netbomo/datalogger-project/Firmware/readme.md

# FIRMWARE [Development branch!]
Here are firmware's files for the windlogger project.

##windlogger_cpp
Software under development
Others are draft or test.

##windlogger_dev_output_0310
Here is an older firmware but with the SD card libary.

Work is under development and lot's of function need to be implemented.
