netbomo/datalogger-project/Hardware/digital_v120/readme.md

# DIGITAL version 1.1.1
This board contains all the needs to use an Atmega1284p like an Arduino. But because it's a prototype board, the power is a small shield to be upgradable. On this digital board, the shield can be plug.
A sd card module and a transmitter module can be add too. This permit to collect data on the SD card and/or send it by wifi or gprs.

## BLOCK DIAGRAM

todo

## RENDER PREVIEW
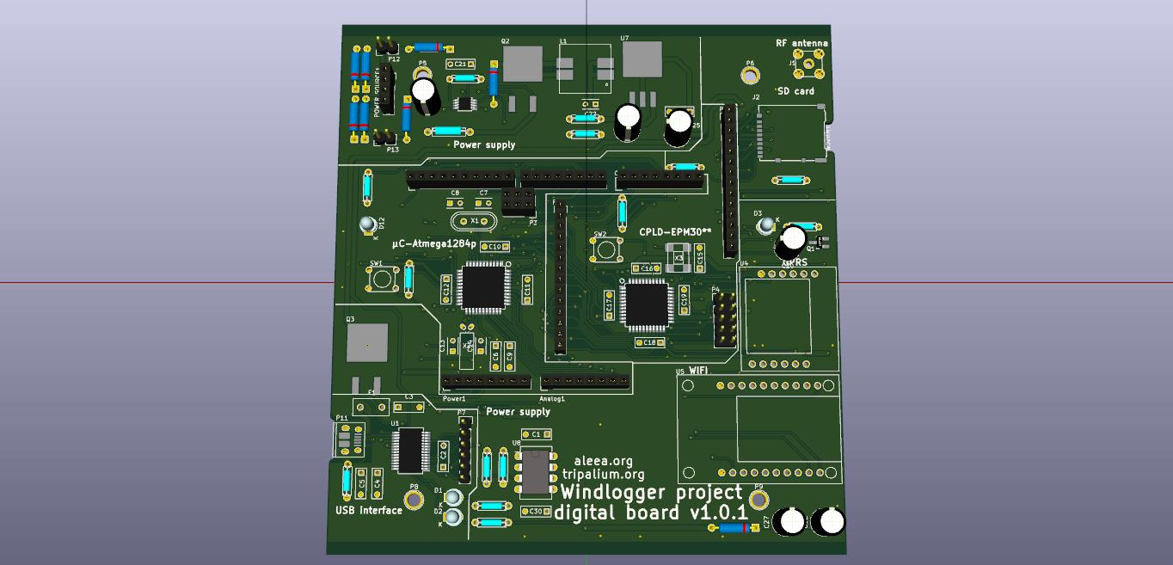
[picture p1: Hardware/digital_v111/digital_preview.jpg]
windlogger digital render preview
