netbomo/datalogger-project/Hardware/shield_v210/readme.md

# SHIELD
This board contains the functions to convert the signals from sensors to signals for the microcontroller.

This board is design to be plug in the digital board, but you can use it with an arduino uno or mega.

Comment are insert in the schematic, open the kicad project or the pdf export to read those.

## BLOCK DIAGRAM
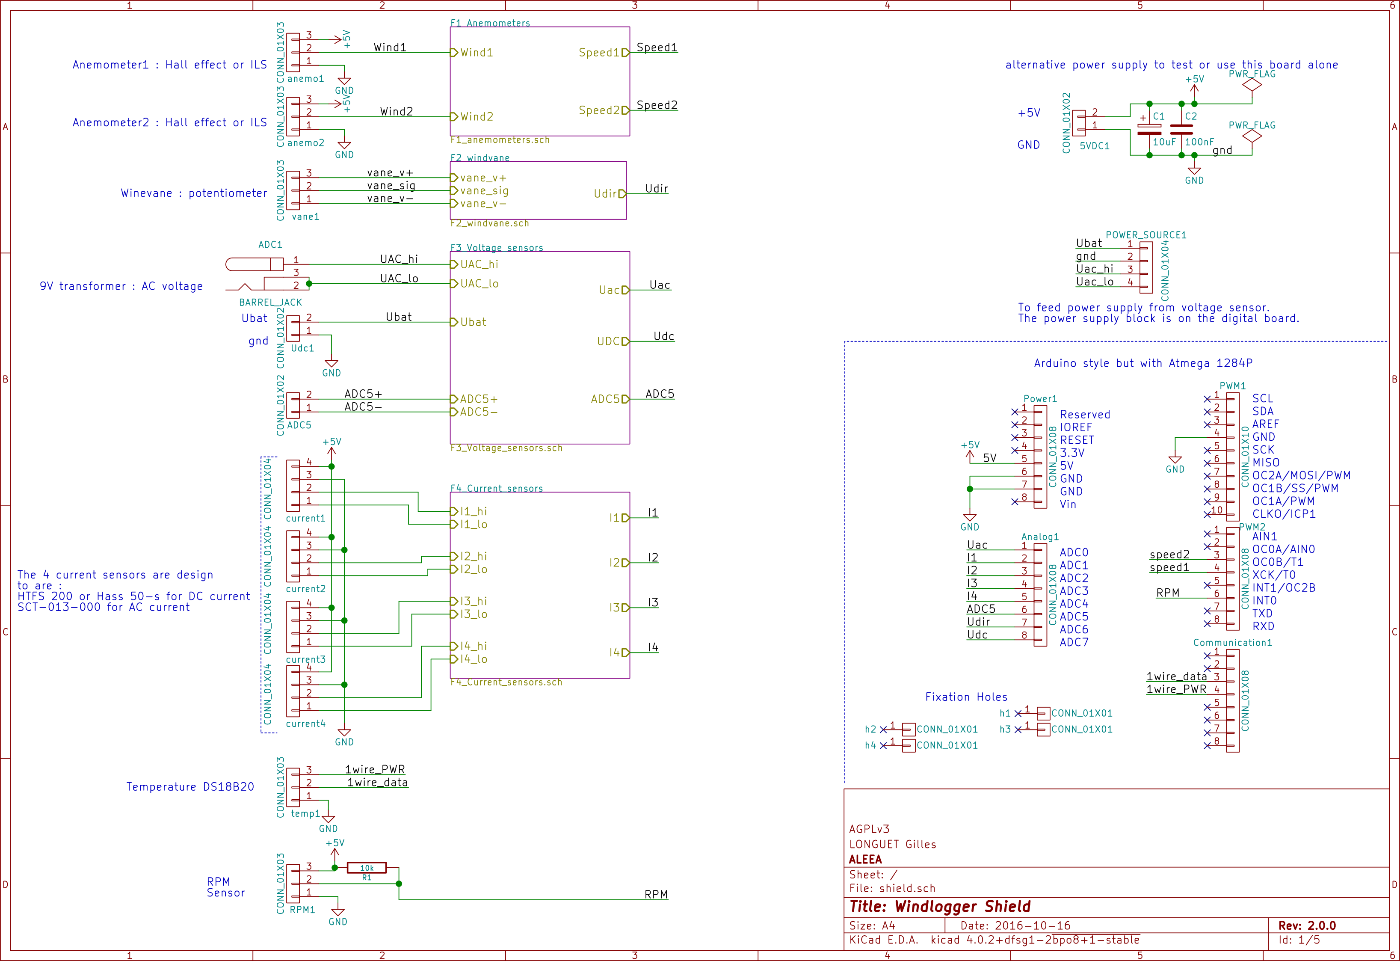
[picture p2: Hardware/shield_v201/shield_bd.png]
windlogger shield block diagram


## RENDER PREVIEW
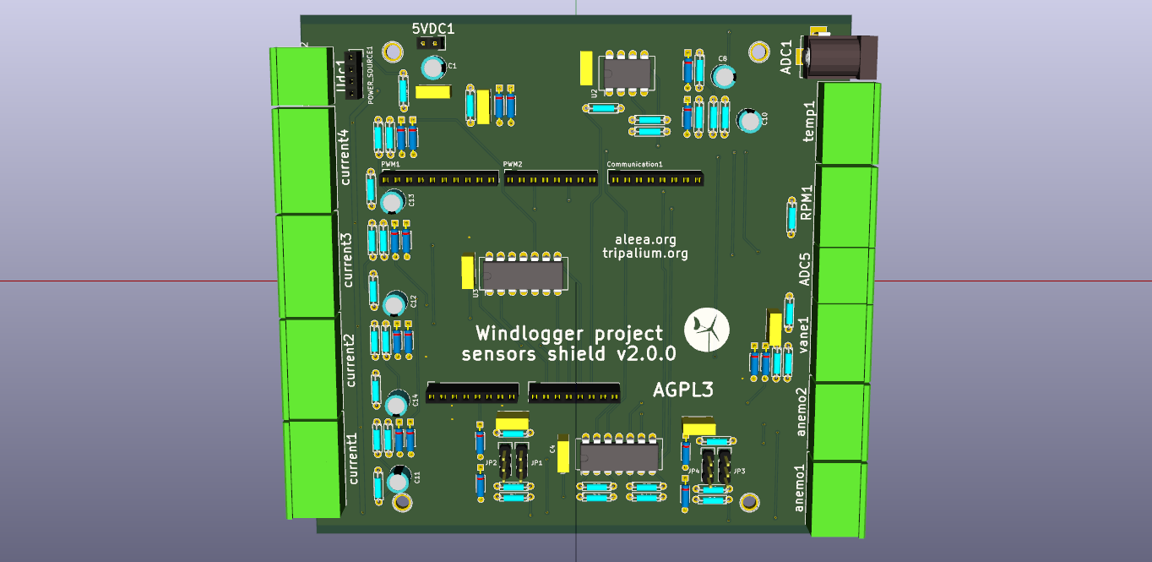
[picture p3: Hardware/shield_v201/shield_pcb.png]
windlogger shield render preview


## Todo list
- chose the componants
- update the BOM
- route the board
- test
