netbomo/datalogger-project/Hardware/digital_v120/kicad/version_1_1_1/BOM_digital_1_1_1.ods

Component | Description | References | Value | Footprint | Quantité/PCB | Famille | Type | Fabricant | Fournisseur | code achat | Commantaires
1 | Connector, single row, 01x08 | Analog1 PWM2 Power1 Communication1 | CONN_01X08 | Socket_Strip_Straight_1x08 | 4 | Connecteur | TH | Connfly | Conradpro | 1498261 - 62
2 | Unpolarized capacitor | C1 C4 C5 C6 C9 C12 C18 C19 C21 C22 | 100n | C_Rect_L7_W2.5_P5 | 10 | Passif | TH | Kemet | Conradpro | 1235240 - 62
3 | Unpolarized capacitor | C13 | 10n | C_Rect_L7_W2.5_P5 | 1 | Passif | TH | Kemet | Conradpro | 1235247 – 62
4 | Polarised capacitor | C14 C15 C16 C17 | 120u | C_Radial_D8_L11.5_P3.5 | 4 | Passif | TH | Yageo | Conradpro | 442617 - 62
5 | Unpolarized capacitor | C7 C8 | 12p | C_Rect_L4_W2.5_P2.5 | 2 | Passif | TH | ? | Conradpro | 457132 - 62
6 | Unpolarized capacitor | C2 C3 | 18p | C_Rect_L4_W2.5_P2.5 | 2 | Passif | TH | ? | Conradpro | 457159 - 62
7 | Polarised capacitor | C10 C11 | 1u | C_Radial_D5_L6_P2.5 | 2 | Passif | TH | Yageo | Conradpro | 445724 - 62
8 |  | D9 | BZX79-C4V7,113 | Diode_DO-35_SOD27_Horizontal_RM10 | 1 | Semi-conducteur | TH | NXP | Conradpro | 1111120 - 62
9 |  | D1 D2 | Led_Small | LED-3MM | 2 | Semi-conducteur | TH | kingbright | Conradpro | 180156 - 62
10 | Schottky diode | D3 D4 D5 D6 D7 D8 | SR5100 | Diode_DO-27_Horizontal_RM12 | 6 | Semi-conducteur | TH | PanJit | Conradpro | 1304978 - 62
11 | PDIP40, 128k Flash, 16k SRAM, 4k EEPROM, JTAG | IC1 | ATMEGA1284P-P | DIP-40_W15.24mm_LongPads | 1 | Circuit intégré | TH | Atmel | RS | 922-1079 | Existe par 1 : 719-3932
12 | BNC, female, right angle, panel mount, through hole | J1 | CONN-SMA-5-1814400-1 | conn-SMA_TE-5-1814400-1 | 1 | Connecteur |  |  |  |  | Ne pas commander
13 | Micro SD card connector | J2 | Micro_SD | HIROSE-MICROSD-DM3AT-SF | 1 | Connecteur | TH | Hirose | RS | 828-1884
14 |  | L1 | 47u | inductance_murata_1200LRS | 1 | Passif | TH | Murata | RS | 715-7308
15 |  | Mod2 | RFM69CW | RFM69CW | 1 | Module |  |  |  |  | Ne pas commander
16 |  | Mod1 | SIM800L | GPRS-SIM80L-smaller | 1 | Module
17 |  | Mod3 | huzzah | adafruit-huzzah | 1 | Module
18 | Connector, single row, 01x03 | P2 | CONN_01X03 | Pin_Header_Angled_1x03 | 1 | Connecteur | TH | E-garry | Conradpro | 733824 - 62
19 | Connector, double row, 02x03 | P3 | ISP | Socket_Strip_Straight_2x03 | 1 | Connecteur | TH | W+P | Conradpro | 737480 - 62
20 | Connector, single row, 01x06 | P1 | USART0 | uart_usb_cp2102_module | 1 | Module |  |  |  |  | Fourni avec le module
21 | Connector, single row, 01x04 | POWER_SOURCE1 | CONN_01X04 | Socket_Strip_Straight_1x04 | 1 | Connecteur | TH | Connfly | Conradpro | 1498355 - 62
22 | Connector, single row, 01x10 | PWM1 | CONN_01X10 | Socket_Strip_Straight_1x10 | 1 | Connecteur | TH | Connfly | Conradpro | 1498357 - 62
23 | Transistor P-MOSFET with substrate diode, drain connected to mounting plane (general) | Q2 | NDT2955 | SOT-223 | 1 | Semi-conducteur | SMD | Fairchild | Conradpro | 1264978 - 62
24 | Transistor N-MOSFETwith substrate diode (general) | Q1 | NTR4501N | SOT-23_Handsoldering | 1 | Semi-conducteur | SMD | Fairchild | Conradpro | 1264012 - 62
25 | Resistor | R4 R8 | 100k | Resistor_Horizontal_RM10mm | 2 | Passif | TH | ? | Conradpro | 1088983 - 62
26 | Resistor | R10 | 10k | Resistor_Horizontal_RM10mm | 1 | Passif | TH | ? | Conradpro | 1089007 - 62
27 | Resistor | R1 R3 | 270 | Resistor_Horizontal_RM10mm | 2 | Passif | TH | ? | Conradpro | 408093 - 62
28 | Resistor | R2 R9 | 470k | Resistor_Horizontal_RM10mm | 2 | Passif | TH | ? | Conradpro | 408484 - 62
29 | Connector, single row, 01x02 | S1 S2 S3 S4 | CONN_SOLDERABLE | CONN_SOLDERABLE | 3 | Circuit intégré |  |  |  |  | Pad à souder
30 |  | SW1 | button-touch-6x6mm | button-touch-6x6mm | 1 | Mécanique | TH | Namae | Conradpro | 705273 - 62
31 | Hex Buffer | U1 | 74HC4050 | SOIC-16_3.9x9.9mm_Pitch1.27mm | 1 | Circuit intégré | SMD | NXP | Conradpro | 144444 - 62
32 | 12V, 1A Step-Down VR | U7 | LM2672M-5.0 | SOIC-8_3.9x4.9mm_Pitch1.27mm | 1 | Circuit intégré | SMD | Texas Inst | Conradpro | 1013858 - 62
33 | Dual Op amp (low power) | U8 | LM358 | SOIC-8_3.9x4.9mm_Pitch1.27mm | 1 | Circuit intégré | SMD | Texas Inst | Conradpro | 1071465 - 62
34 | MCP1700, Fixed 250mA Low Dropout Voltage Regulator, Positive | U2 | MCP1700 | TO-92_Horizontal1_Inline_Narrow_Oval | 1 | Circuit intégré | SMD | Microchip | Conradpro | 1085858 - 62
35 | point | W1 W2 W3 W4 W5 W6 W7 | +3.3V +5V +BATT GND GNDPWR USBVCC Vin | Measurement_Point_Square-TH_Big | 7 | Connecteur | TH | Vogt | Conradpro | 1226188 - 62
36 | Two pin crystal | X1 | 16M | Crystal_HC49-U_Vertical | 1 | Passif | TH | Euroquartz | Conradpro | 155145 - 62
37 | Two pin crystal | X2 | 32.768Hz | Crystal_Round_Horizontal_3mm_BigPad | 1 | Passif | TH | Euroquartz | Conradpro | 156098 - 62
