netbomo/datalogger-project/Hardware/digital_v120/PDF/digital.pdf

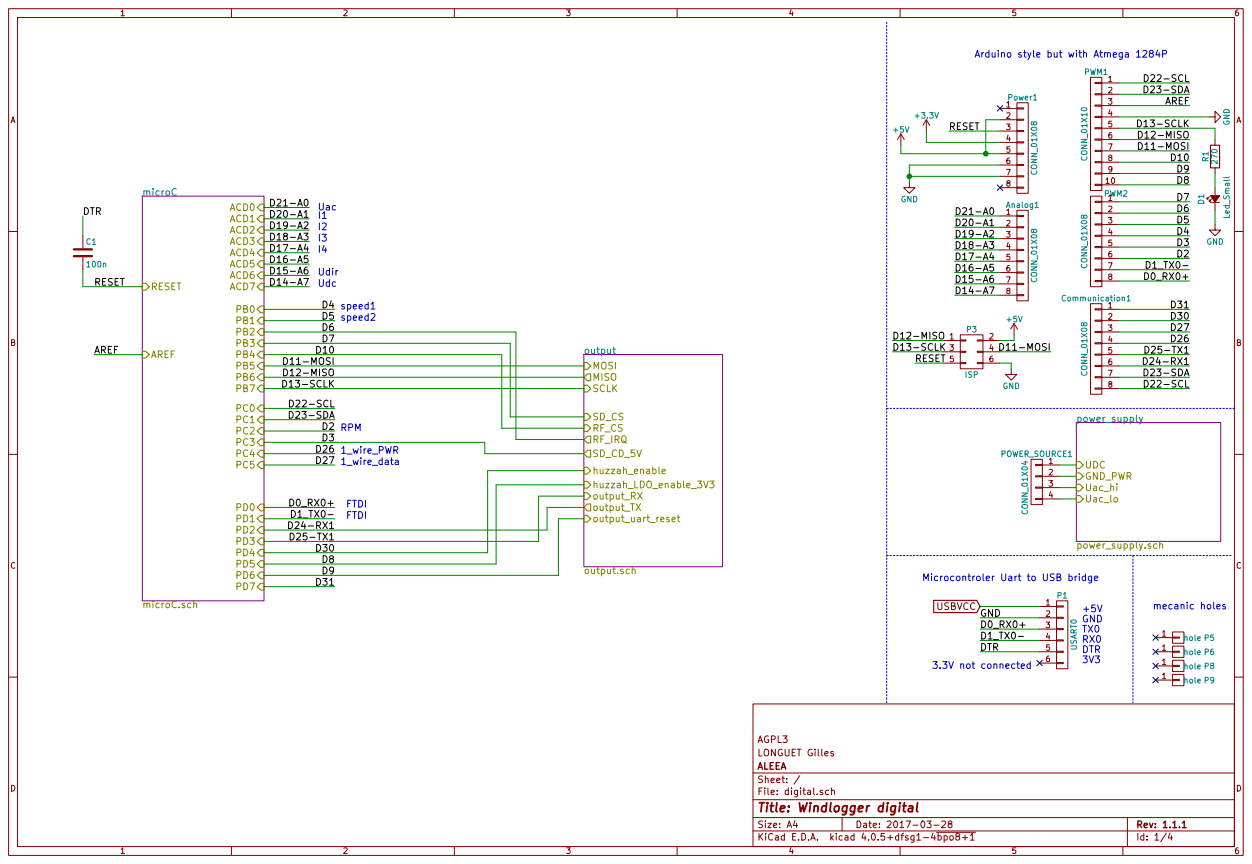
[picture p20: page 1]

D12-MISO
D13-SCLK

File: digital.sch Sheet: / ALEEA

Id: 1/4 Title: Windlogger digital

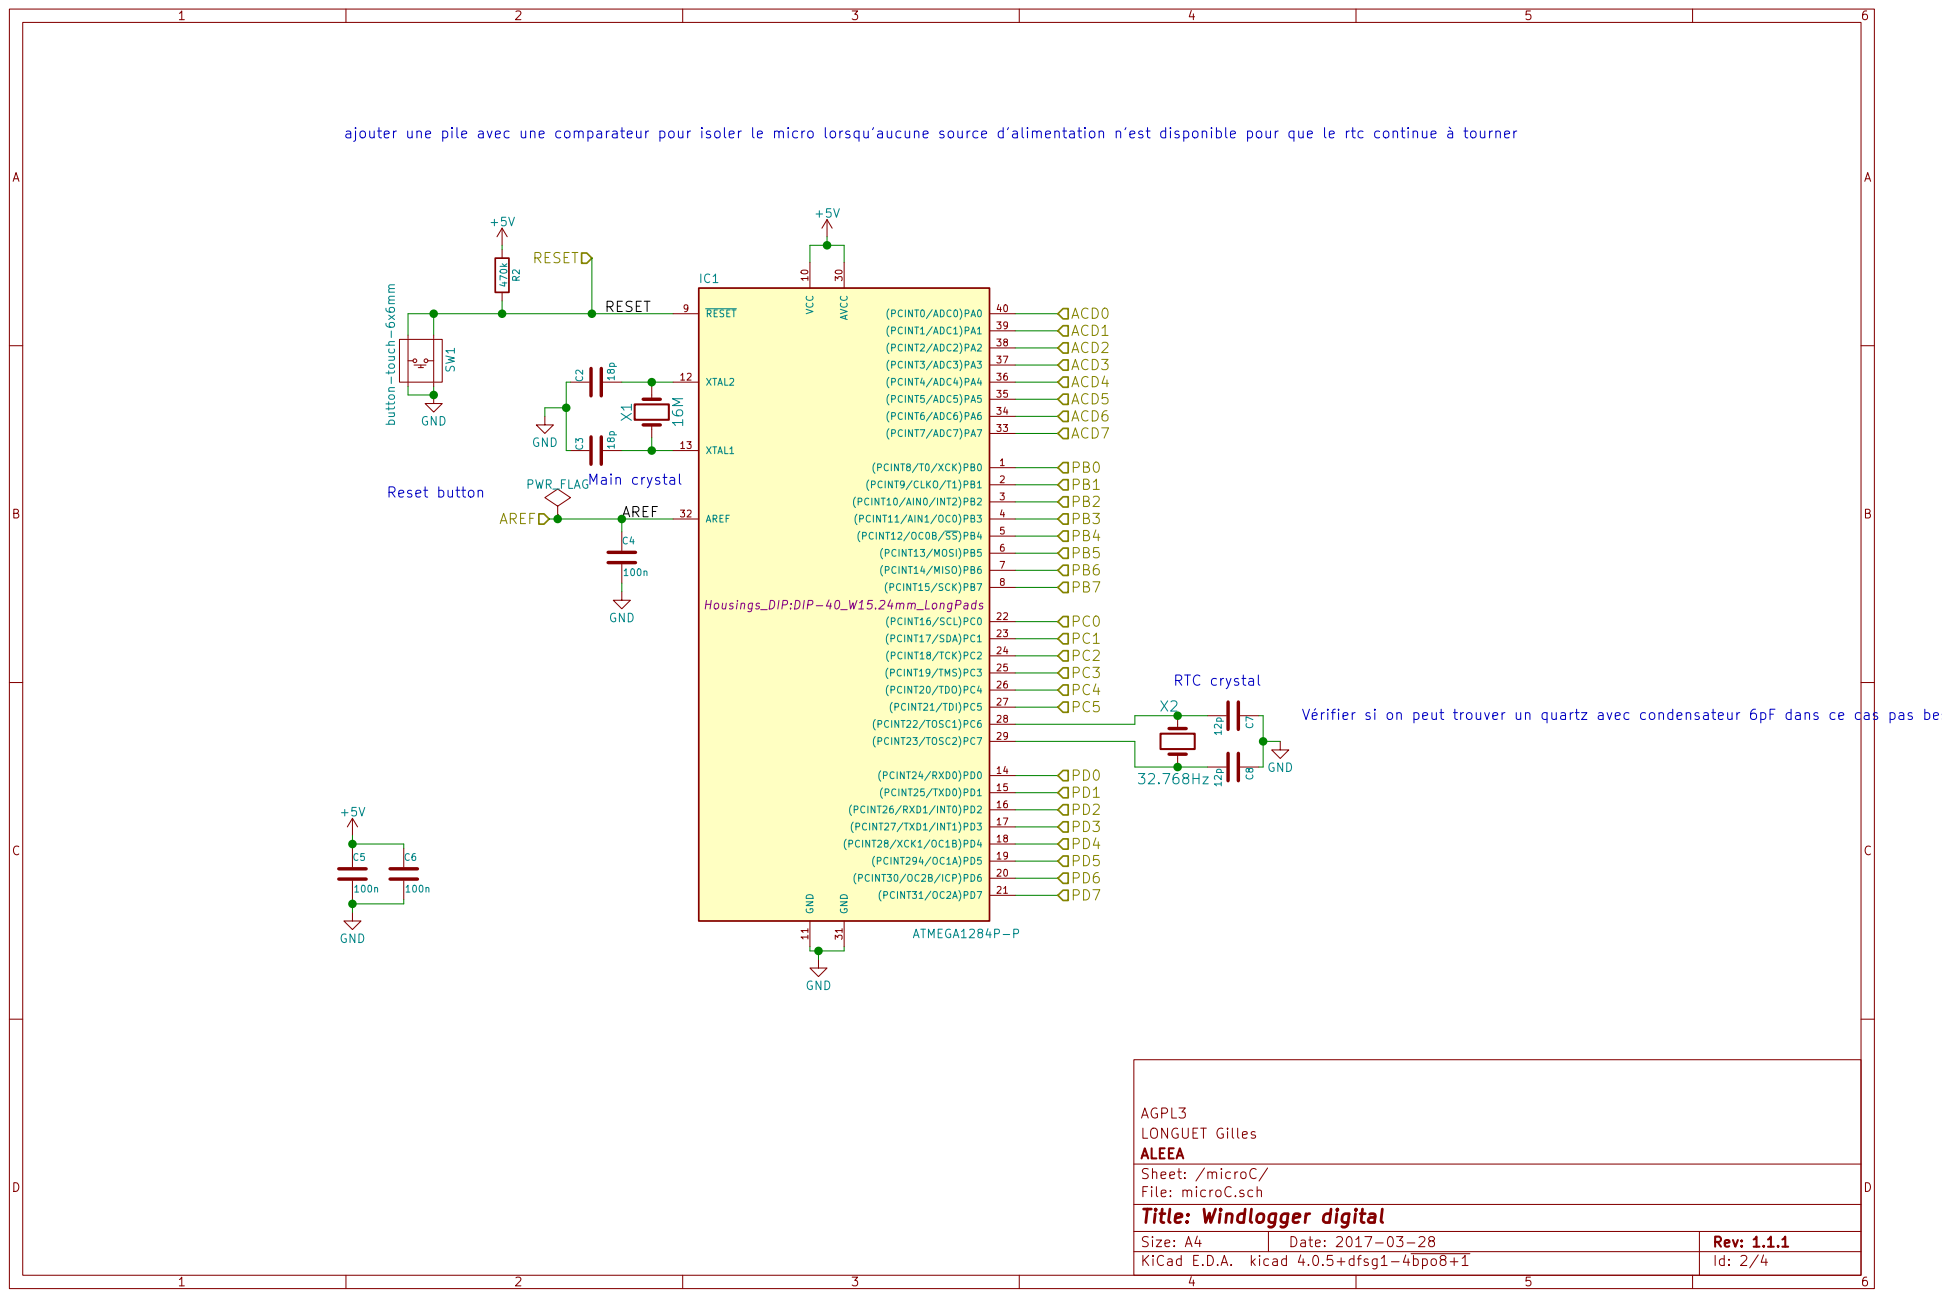
[picture p21: page 2]

ajouter une pile avec une comparateur pour isoler le micro lorsqu'aucune source d'alimentation n'est disponible pour que le rtc continue à tourner

PC5 PD0 PD1 PD2 PD3 PD4 PD5 PD6 PD7 RESET AREF SW1 button-touch-6x6mm

Vérifier si on peut trouver un quartz avec condensateur 6pF dans ce cas pas besoin de C externe

Id: 2/4 Title: Windlogger digital File: microC.sch Sheet: /microC/ ALEEA

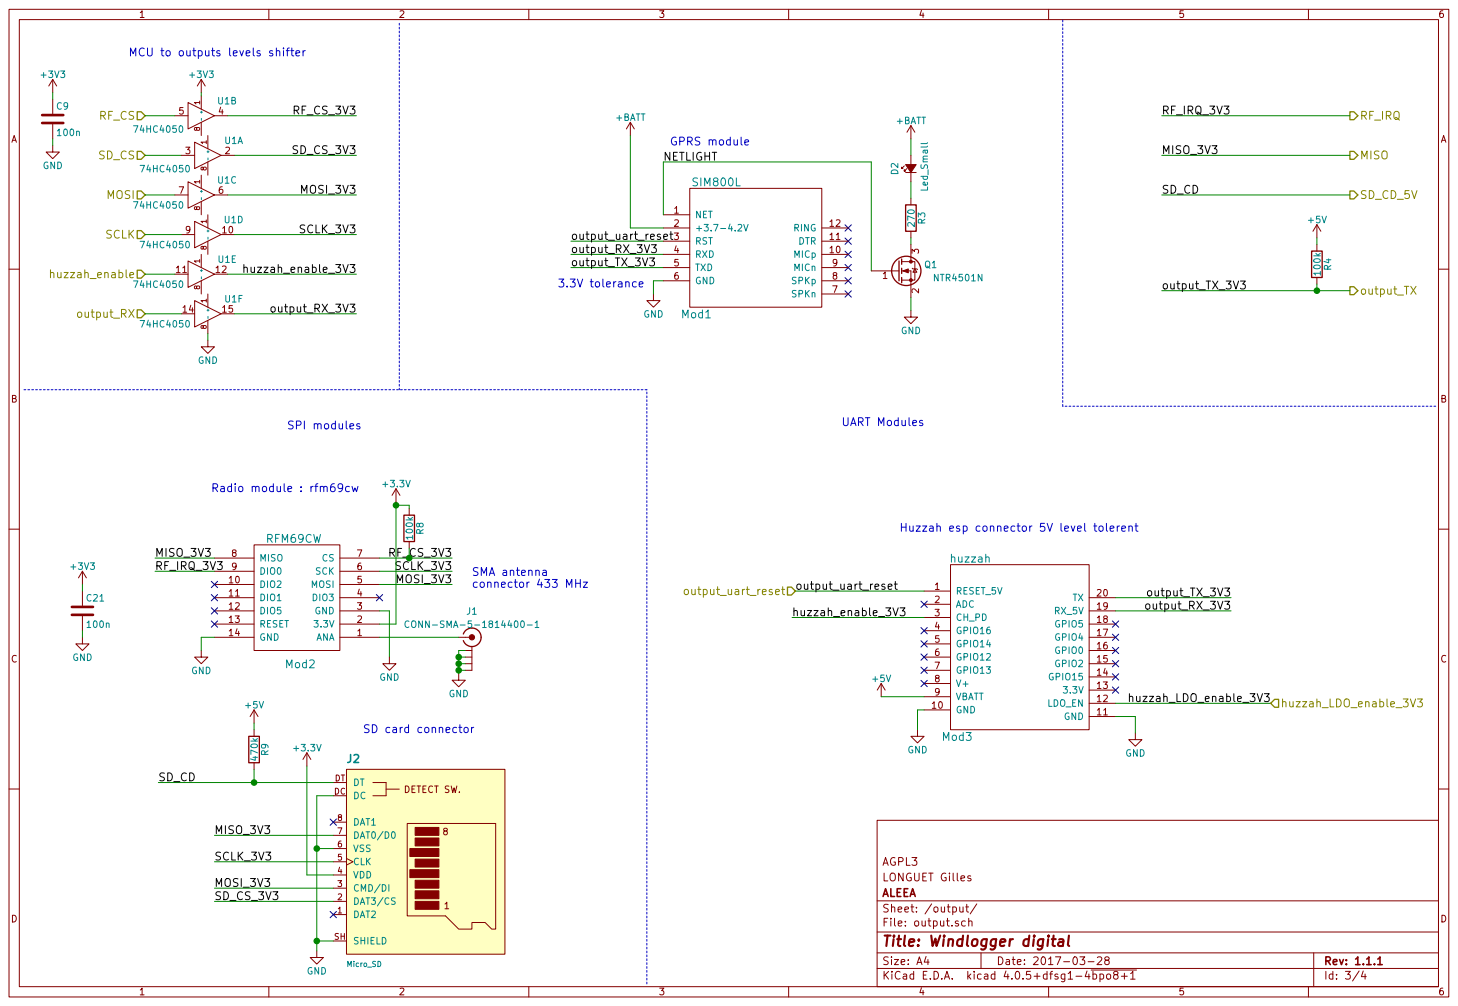
[picture p22: page 3]

74HC4050 MCU to outputs levels shifter
100n +3V3 GND

File: output.sch
Id: 3/4 Title: Windlogger digital

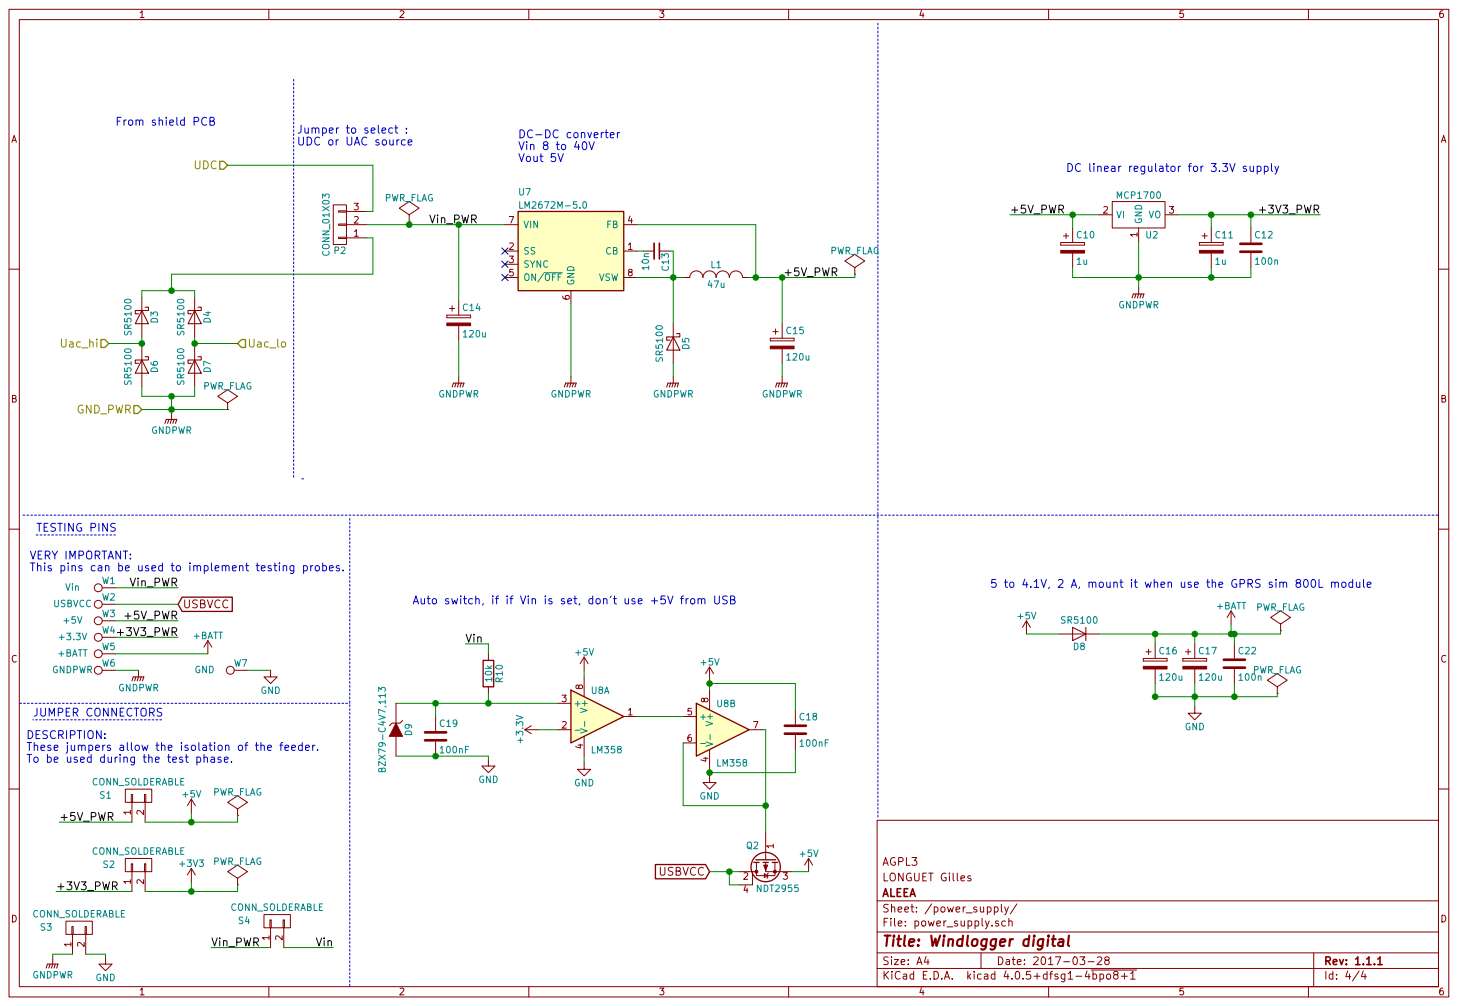
[picture p23: page 4]

UDC or UAC source

DC-DC converter Vin 8 to 40V
Vout 5V

DC linear regulator for 3.3V supply

120u 5 to 4.1V, 2 A, mount it when use the GPRS sim 800L module

Auto switch, if if Vin is set, don't use +5V from USB

JUMPER CONNECTORS
DESCRIPTION:
These jumpers allow the isolation of the feeder.
To be used during the test phase.

File: power_supply.sch
Id: 4/4 Title: Windlogger digital
