netbomo/datalogger-project/Hardware/digital_v120/kicad/digital.sch

## KiCad design Hardware/digital_v120/kicad/digital.sch (2017-07-10)

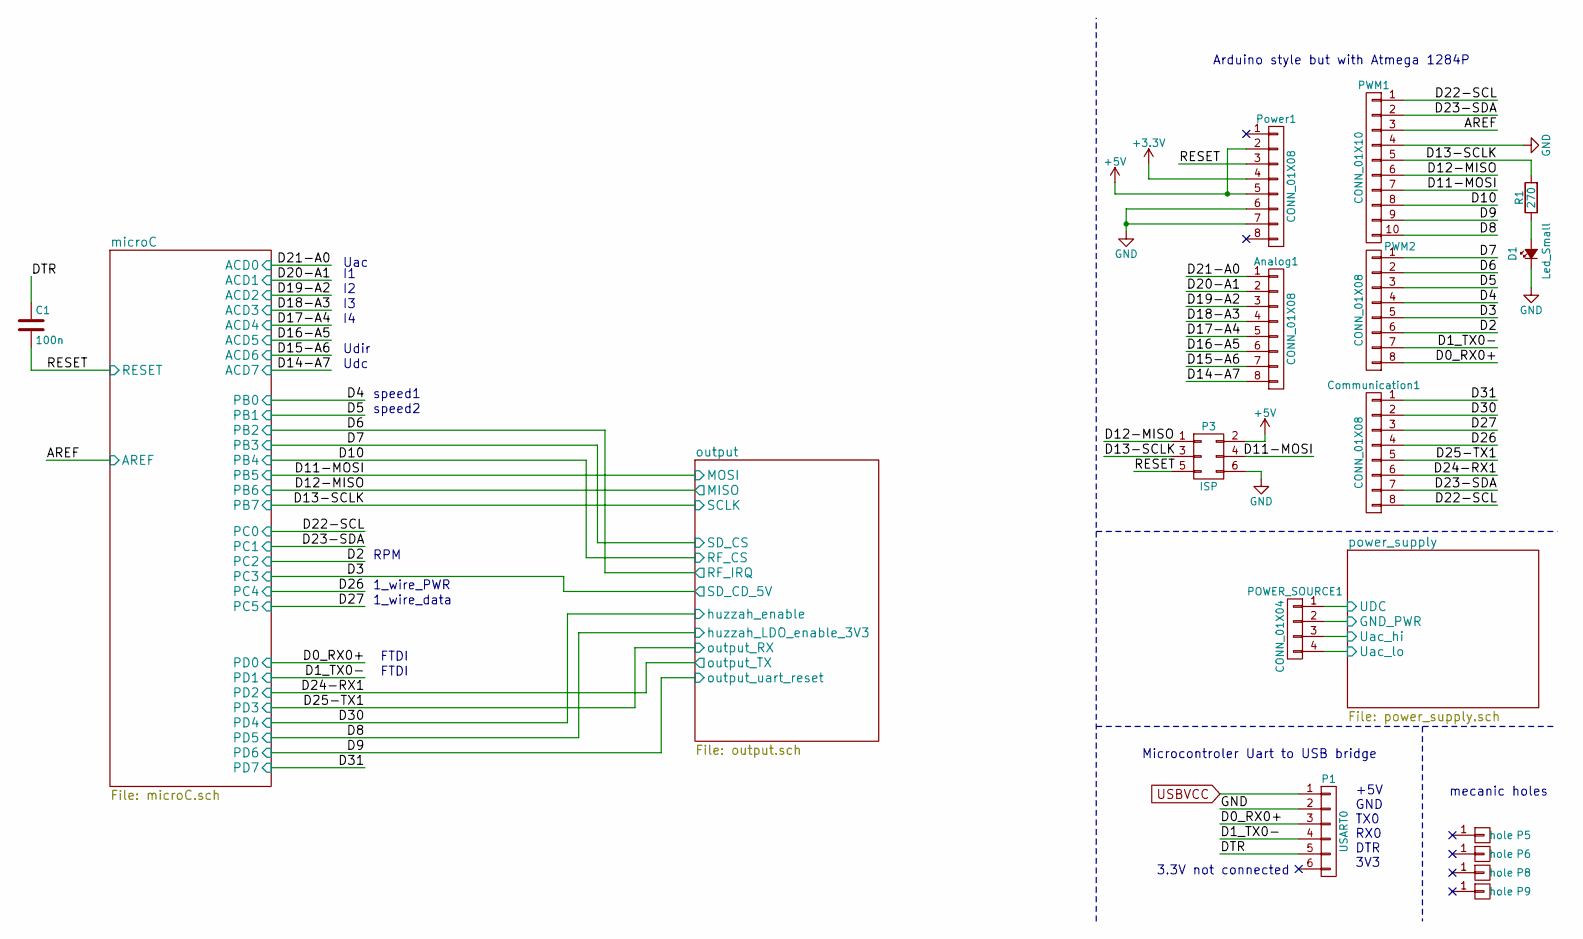
[picture p29: schematic digital.sch]

Parts:
Analog1: CONN_01X08; Socket_Strip_Straight_1x08
C1: 100n; C_Rect_L7_W2.5_P5
Communication1: CONN_01X08; Socket_Strip_Straight_1x08
D1: Led_Small; LED-3MM
P1: USART0; uart_usb_cp2102_module
P3: ISP; Socket_Strip_Straight_2x03
P5, P6, P8, P9: hole; MountingHole_3-5mm
POWER_SOURCE1: CONN_01X04; Socket_Strip_Straight_1x04
PWM1: CONN_01X10; Socket_Strip_Straight_1x10
PWM2: CONN_01X08; Socket_Strip_Straight_1x08
Power1: CONN_01X08; Socket_Strip_Straight_1x08
R1: 270; Resistor_Horizontal_RM10mm

Connections:
+3.3V: Power1.4
+5V: P3.2, Power1.2, Power1.5
AREF: PWM1.3
D0_RX0+: P1.3, PWM2.8
D1_TX0-: P1.4, PWM2.7
D2: PWM2.6
D3: PWM2.5
D4: PWM2.4
D5: PWM2.3
D6: PWM2.2
D7: PWM2.1
D8: PWM1.10
D9: PWM1.9
D10: PWM1.8
D11-MOSI: P3.4, PWM1.7
D12-MISO: P3.1, PWM1.6
D13-SCLK: P3.3, PWM1.5, R1.2
D14-A7: Analog1.8
D15-A6: Analog1.7
D16-A5: Analog1.6
D17-A4: Analog1.5
D18-A3: Analog1.4
D19-A2: Analog1.3
D20-A1: Analog1.2
D21-A0: Analog1.1
D22-SCL: Communication1.8, PWM1.1
D23-SDA: Communication1.7, PWM1.2
D24-RX1: Communication1.6
D25-TX1: Communication1.5
D26: Communication1.4
D27: Communication1.3
D30: Communication1.2
D31: Communication1.1
DTR: C1.1, P1.5
GND: D1.1 (K), P1.2, P3.6, PWM1.4, Power1.6, Power1.7
GND_PWR: POWER_SOURCE1.2
unnamed: D1.2 (A), R1.1
RESET: C1.2, P3.5, Power1.3
UDC: POWER_SOURCE1.1
USBVCC: P1.1
Uac_hi: POWER_SOURCE1.3
Uac_lo: POWER_SOURCE1.4

Notes on the sheet:
mecanic holes
Arduino style but with Atmega 1284P
Microcontroler Uart to USB bridge
Uac
Udir
Udc
speed1
speed2
1_wire_PWR
1_wire_data
FTDI
RPM
3.3V not connected
+5V GND TX0 RX0 DTR 3V3
