netbomo/datalogger-project/Hardware/digital_v120/kicad/microC.sch

## KiCad design Hardware/digital_v120/kicad/microC.sch (2017-07-10)

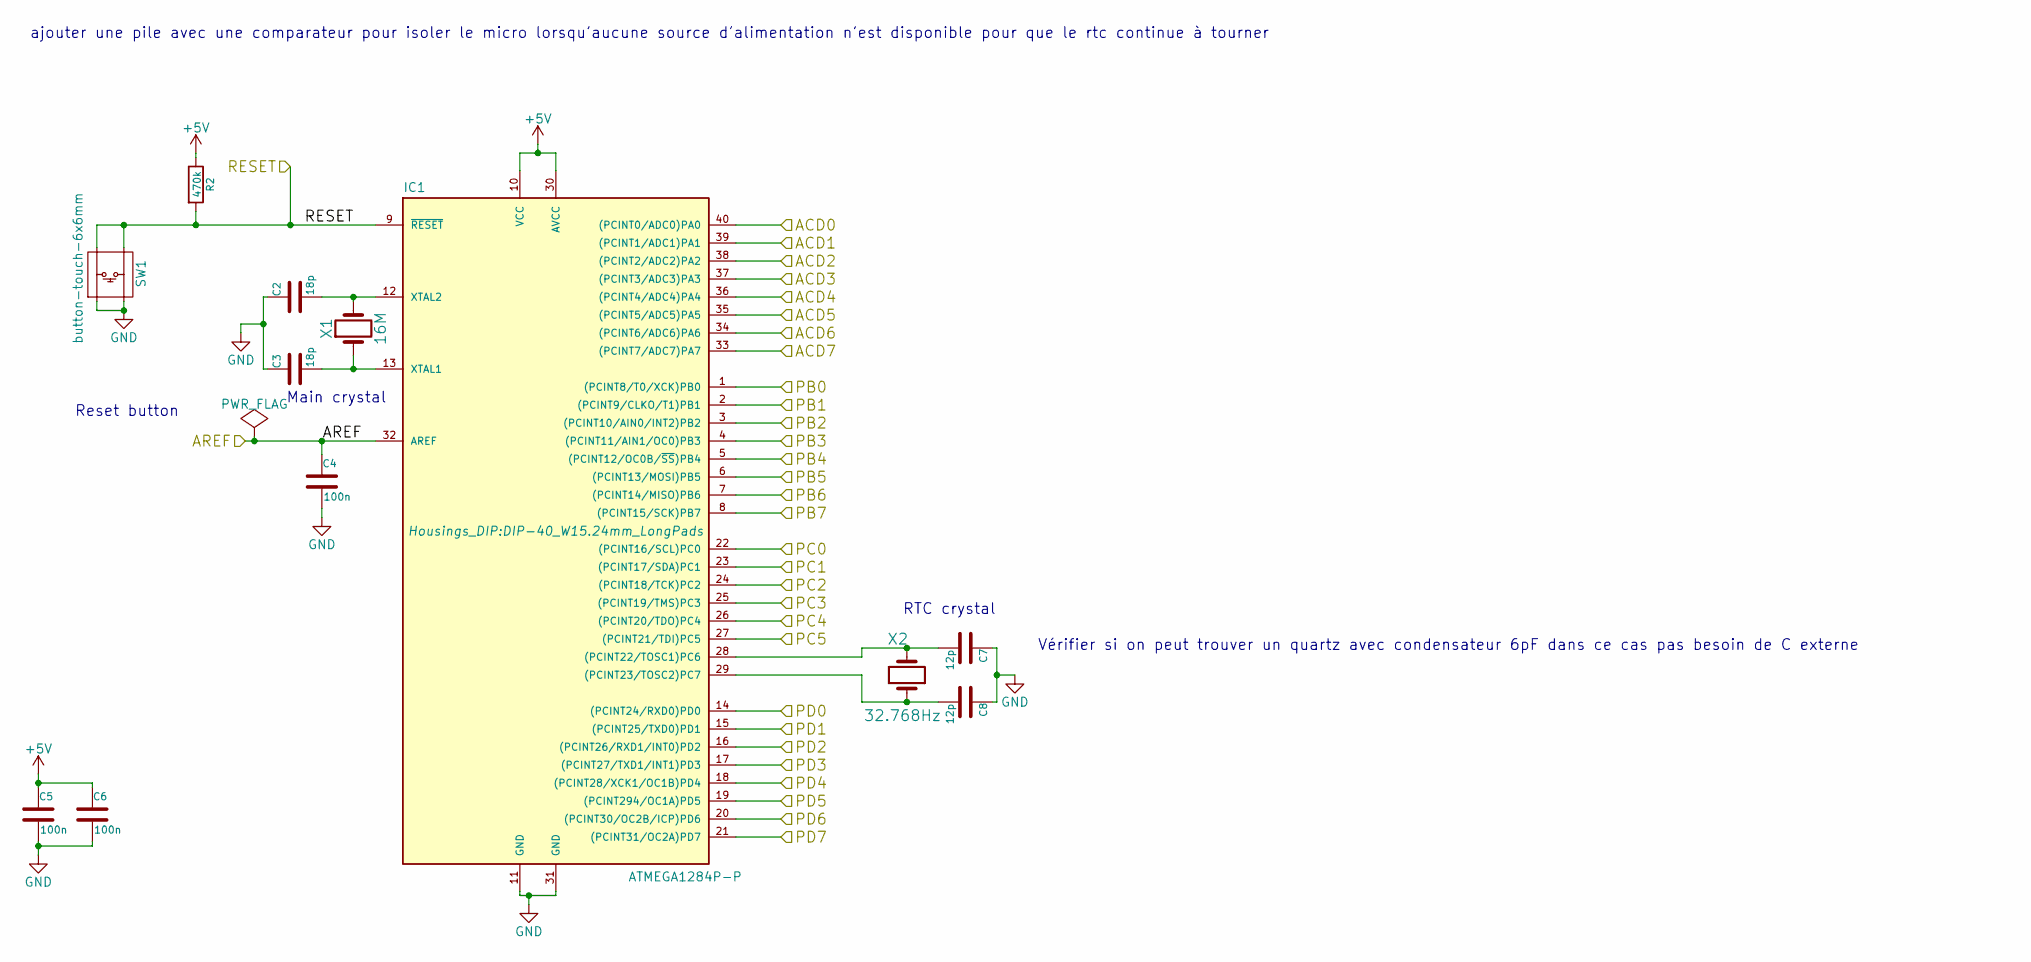
[picture p30: schematic microC.sch]

Parts:
C2, C3: 18p; C_Rect_L4_W2.5_P2.5
C4, C5, C6: 100n; C_Rect_L7_W2.5_P5
C7, C8: 12p; C_Rect_L4_W2.5_P2.5
IC1: ATMEGA1284P-P; DIP-40_W15.24mm_LongPads
R2: 470k; Resistor_Horizontal_RM10mm
SW1: button-touch-6x6mm
X1: 16M; Crystal_HC49-U_Vertical
X2: 32.768Hz; Crystal_Round_Horizontal_3mm_BigPad

Connections:
+5V: C5.1, C6.1, IC1.10 (VCC), IC1.30 (AVCC), R2.1
ACD0: IC1.40 ((PCINT0/ADC0)PA0)
ACD1: IC1.39 ((PCINT1/ADC1)PA1)
ACD2: IC1.38 ((PCINT2/ADC2)PA2)
ACD3: IC1.37 ((PCINT3/ADC3)PA3)
ACD4: IC1.36 ((PCINT4/ADC4)PA4)
ACD5: IC1.35 ((PCINT5/ADC5)PA5)
ACD6: IC1.34 ((PCINT6/ADC6)PA6)
ACD7: IC1.33 ((PCINT7/ADC7)PA7)
AREF: C4.1, IC1.32 (AREF)
GND: C2.1, C3.1, C4.2, C5.2, C6.2, C7.1, C8.1, IC1.11 (GND), IC1.31 (GND), SW1.1, SW1.3
unnamed: C2.2, IC1.12 (XTAL2), X1.2
unnamed: C3.2, IC1.13 (XTAL1), X1.1
unnamed: C7.2, IC1.28 ((PCINT22/TOSC1)PC6), X2.2
unnamed: C8.2, IC1.29 ((PCINT23/TOSC2)PC7), X2.1
PB0: IC1.1 ((PCINT8/T0/XCK)PB0)
PB1: IC1.2 ((PCINT9/CLKO/T1)PB1)
PB2: IC1.3 ((PCINT10/AIN0/INT2)PB2)
PB3: IC1.4 ((PCINT11/AIN1/OC0)PB3)
PB4: IC1.5 ((PCINT12/OC0B/~SS~)PB4)
PB5: IC1.6 ((PCINT13/MOSI)PB5)
PB6: IC1.7 ((PCINT14/MISO)PB6)
PB7: IC1.8 ((PCINT15/SCK)PB7)
PC0: IC1.22 ((PCINT16/SCL)PC0)
PC1: IC1.23 ((PCINT17/SDA)PC1)
PC2: IC1.24 ((PCINT18/TCK)PC2)
PC3: IC1.25 ((PCINT19/TMS)PC3)
PC4: IC1.26 ((PCINT20/TDO)PC4)
PC5: IC1.27 ((PCINT21/TDI)PC5)
PD0: IC1.14 ((PCINT24/RXD0)PD0)
PD1: IC1.15 ((PCINT25/TXD0)PD1)
PD2: IC1.16 ((PCINT26/RXD1/INT0)PD2)
PD3: IC1.17 ((PCINT27/TXD1/INT1)PD3)
PD4: IC1.18 ((PCINT28/XCK1/OC1B)PD4)
PD5: IC1.19 ((PCINT294/OC1A)PD5)
PD6: IC1.20 ((PCINT30/OC2B/ICP)PD6)
PD7: IC1.21 ((PCINT31/OC2A)PD7)
RESET: IC1.9 (~RESET), R2.2, SW1.2, SW1.4

Notes on the sheet:
Main crystal
RTC crystal
Reset button
Vérifier si on peut trouver un quartz avec condensateur 6pF dans ce cas pas besoin de C externe
ajouter une pile avec une comparateur pour isoler le micro lorsqu'aucune source d'alimentation n'est disponible pour que le rtc continue à tourner
