netbomo/datalogger-project/Hardware/digital_v120/kicad/output.sch

## KiCad design Hardware/digital_v120/kicad/output.sch (2017-07-10)

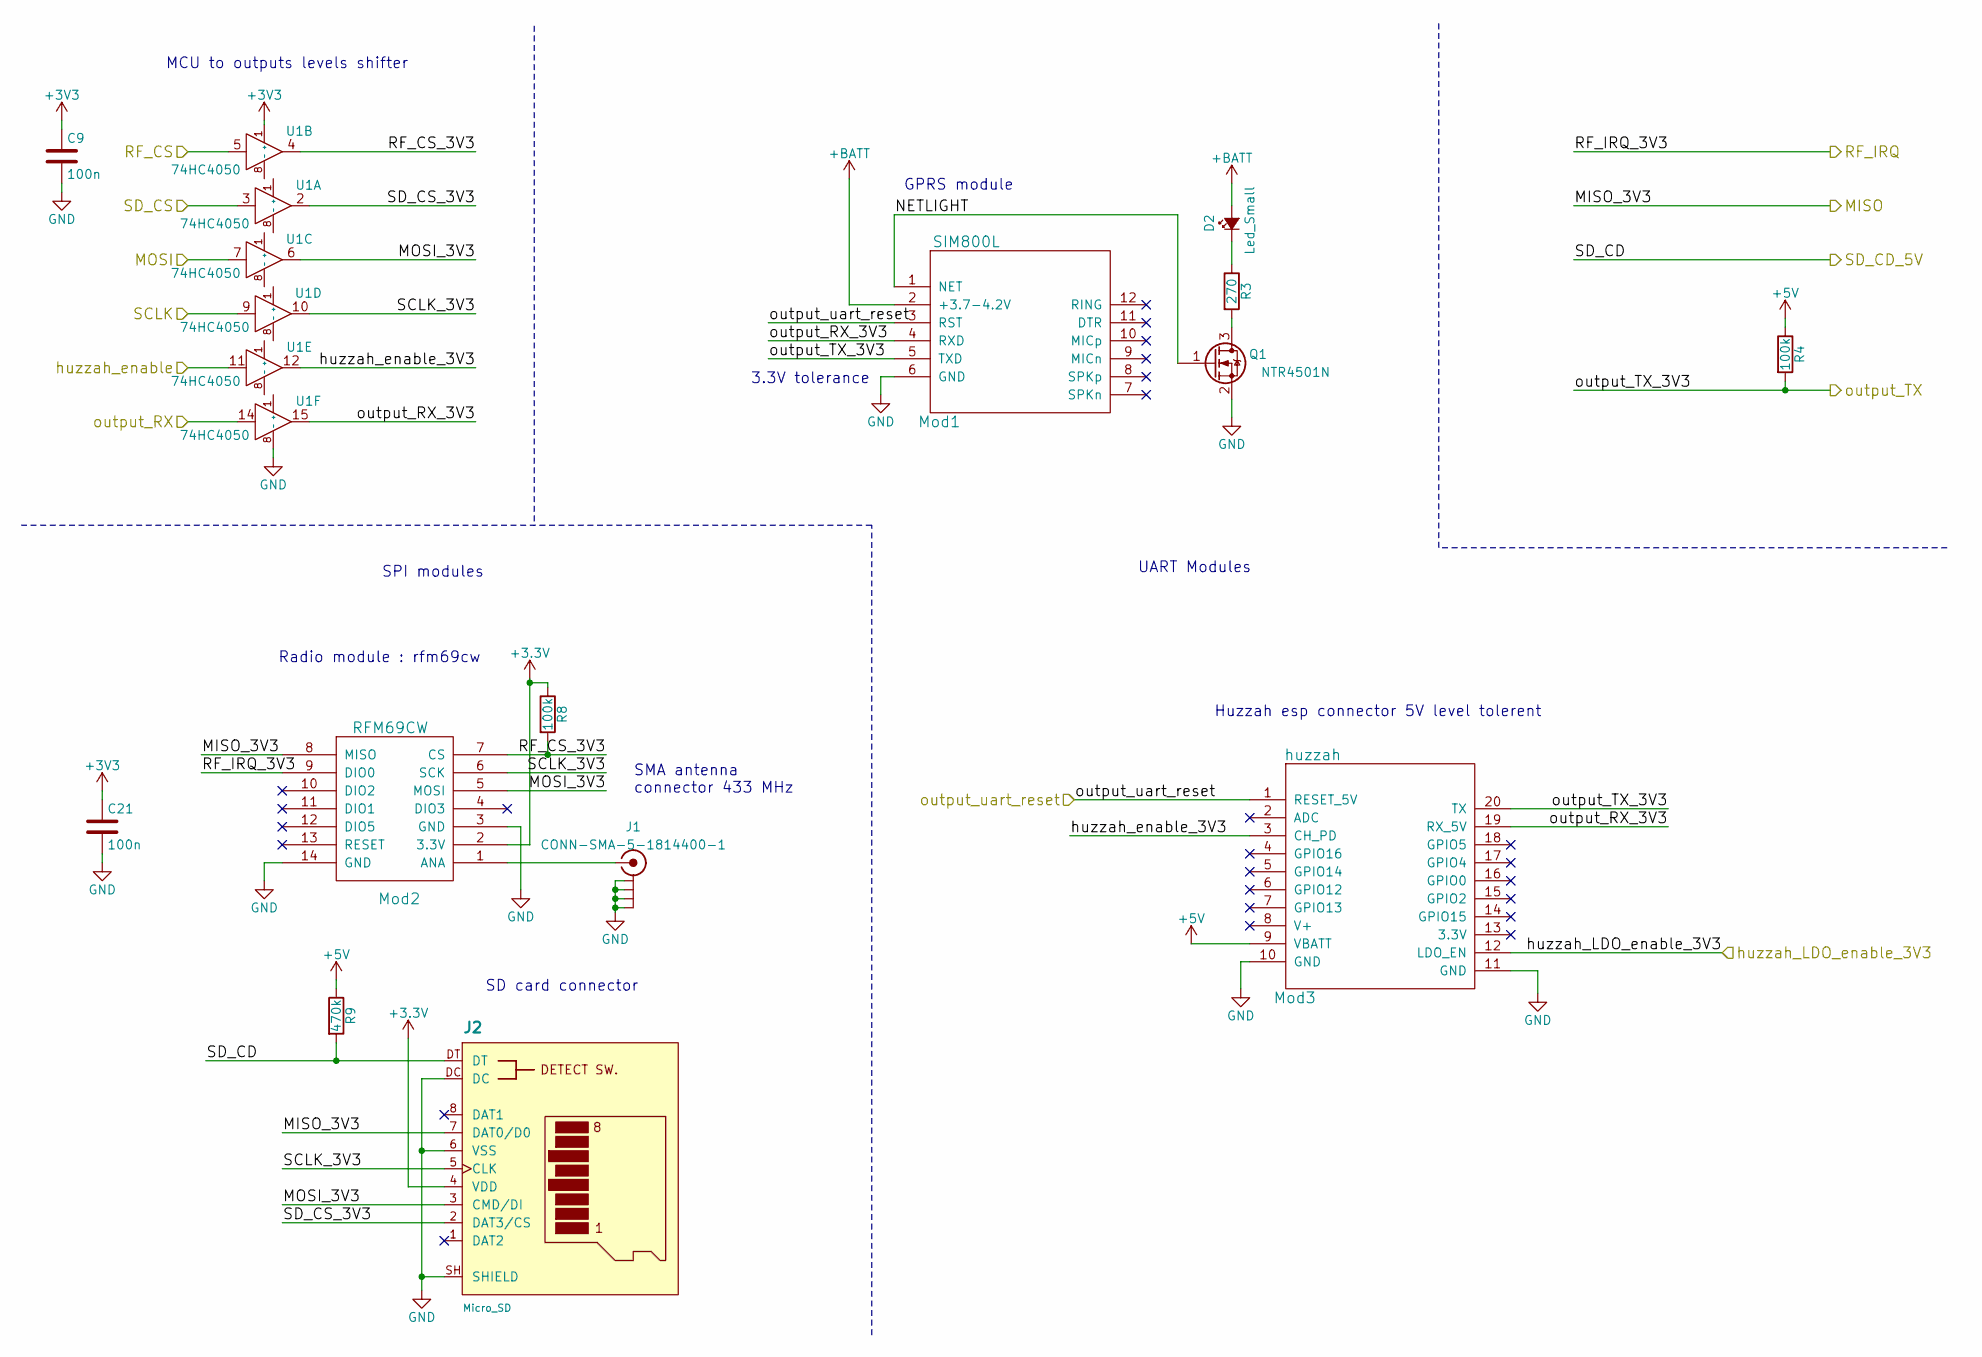
[picture p31: schematic output.sch]

Parts:
C9, C21: 100n; C_Rect_L7_W2.5_P5
D2: Led_Small; LED-3MM
J1: CONN-SMA-5-1814400-1; conn-SMA_TE-5-1814400-1
J2: Micro_SD; HIROSE-MICROSD-DM3AT-SF
Mod1: SIM800L; GPRS-SIM80L-smaller
Mod2: RFM69CW
Mod3: huzzah; adafruit-huzzah
Q1: NTR4501N; SOT-23_Handsoldering
R3: 270; Resistor_Horizontal_RM10mm
R4, R8: 100k; Resistor_Horizontal_RM10mm
R9: 470k; Resistor_Horizontal_RM10mm
U1: 74HC4050; SOIC-16_3.9x9.9mm_Pitch1.27mm

Connections:
+3.3V: J2.4 (VDD), Mod2.2 (3.3V), R8.1
+3V3: C9.1, C21.1, U1.1 (+)
+5V: Mod3.9 (VBATT), R4.1, R9.1
+BATT: D2.2 (A), Mod1.2 (+3.7-4.2V)
GND: C9.2, C21.2, J1.2, J1.3, J1.4, J1.5, J2.6 (VSS), J2.DC, J2.SH (SHIELD), Mod1.6 (GND), Mod2.3 (GND), Mod2.14 (GND), Mod3.10 (GND), Mod3.11 (GND), Q1.2 (S), U1.8 (-)
MISO: J2.7 (DAT0/D0), Mod2.8 (MISO)
MOSI: U1.7
MOSI_3V3: J2.3 (CMD/DI), Mod2.5 (MOSI), U1.6
NETLIGHT: Mod1.1 (NET), Q1.1 (G)
unnamed: D2.1 (K), R3.1
unnamed: J1.1, Mod2.1 (ANA)
unnamed: Q1.3 (D), R3.2
RF_CS: U1.5
RF_CS_3V3: Mod2.7 (CS), R8.2, U1.4
RF_IRQ: Mod2.9 (DIO0)
SCLK: U1.9
SCLK_3V3: J2.5 (CLK), Mod2.6 (SCK), U1.10
SD_CD: J2.DT, R9.2
SD_CS: U1.3
SD_CS_3V3: J2.2 (DAT3/CS), U1.2
huzzah_LDO_enable_3V3: Mod3.12 (LDO_EN)
huzzah_enable: U1.11
huzzah_enable_3V3: Mod3.3 (CH_PD), U1.12
output_RX: U1.14
output_RX_3V3: Mod1.4 (RXD), Mod3.19 (RX_5V), U1.15
output_TX: Mod1.5 (TXD), Mod3.20 (TX), R4.2
output_uart_reset: Mod1.3 (RST), Mod3.1 (RESET_5V)

Notes on the sheet:
Radio module : rfm69cw
Huzzah esp connector 5V level tolerent
GPRS module
SD card connector
3.3V tolerance
SMA antenna connector 433 MHz
MCU to outputs levels shifter
UART Modules
SPI modules
