netbomo/datalogger-project/Hardware/digital_v120/kicad/power_supply.sch

## KiCad design Hardware/digital_v120/kicad/power_supply.sch (2017-07-10)

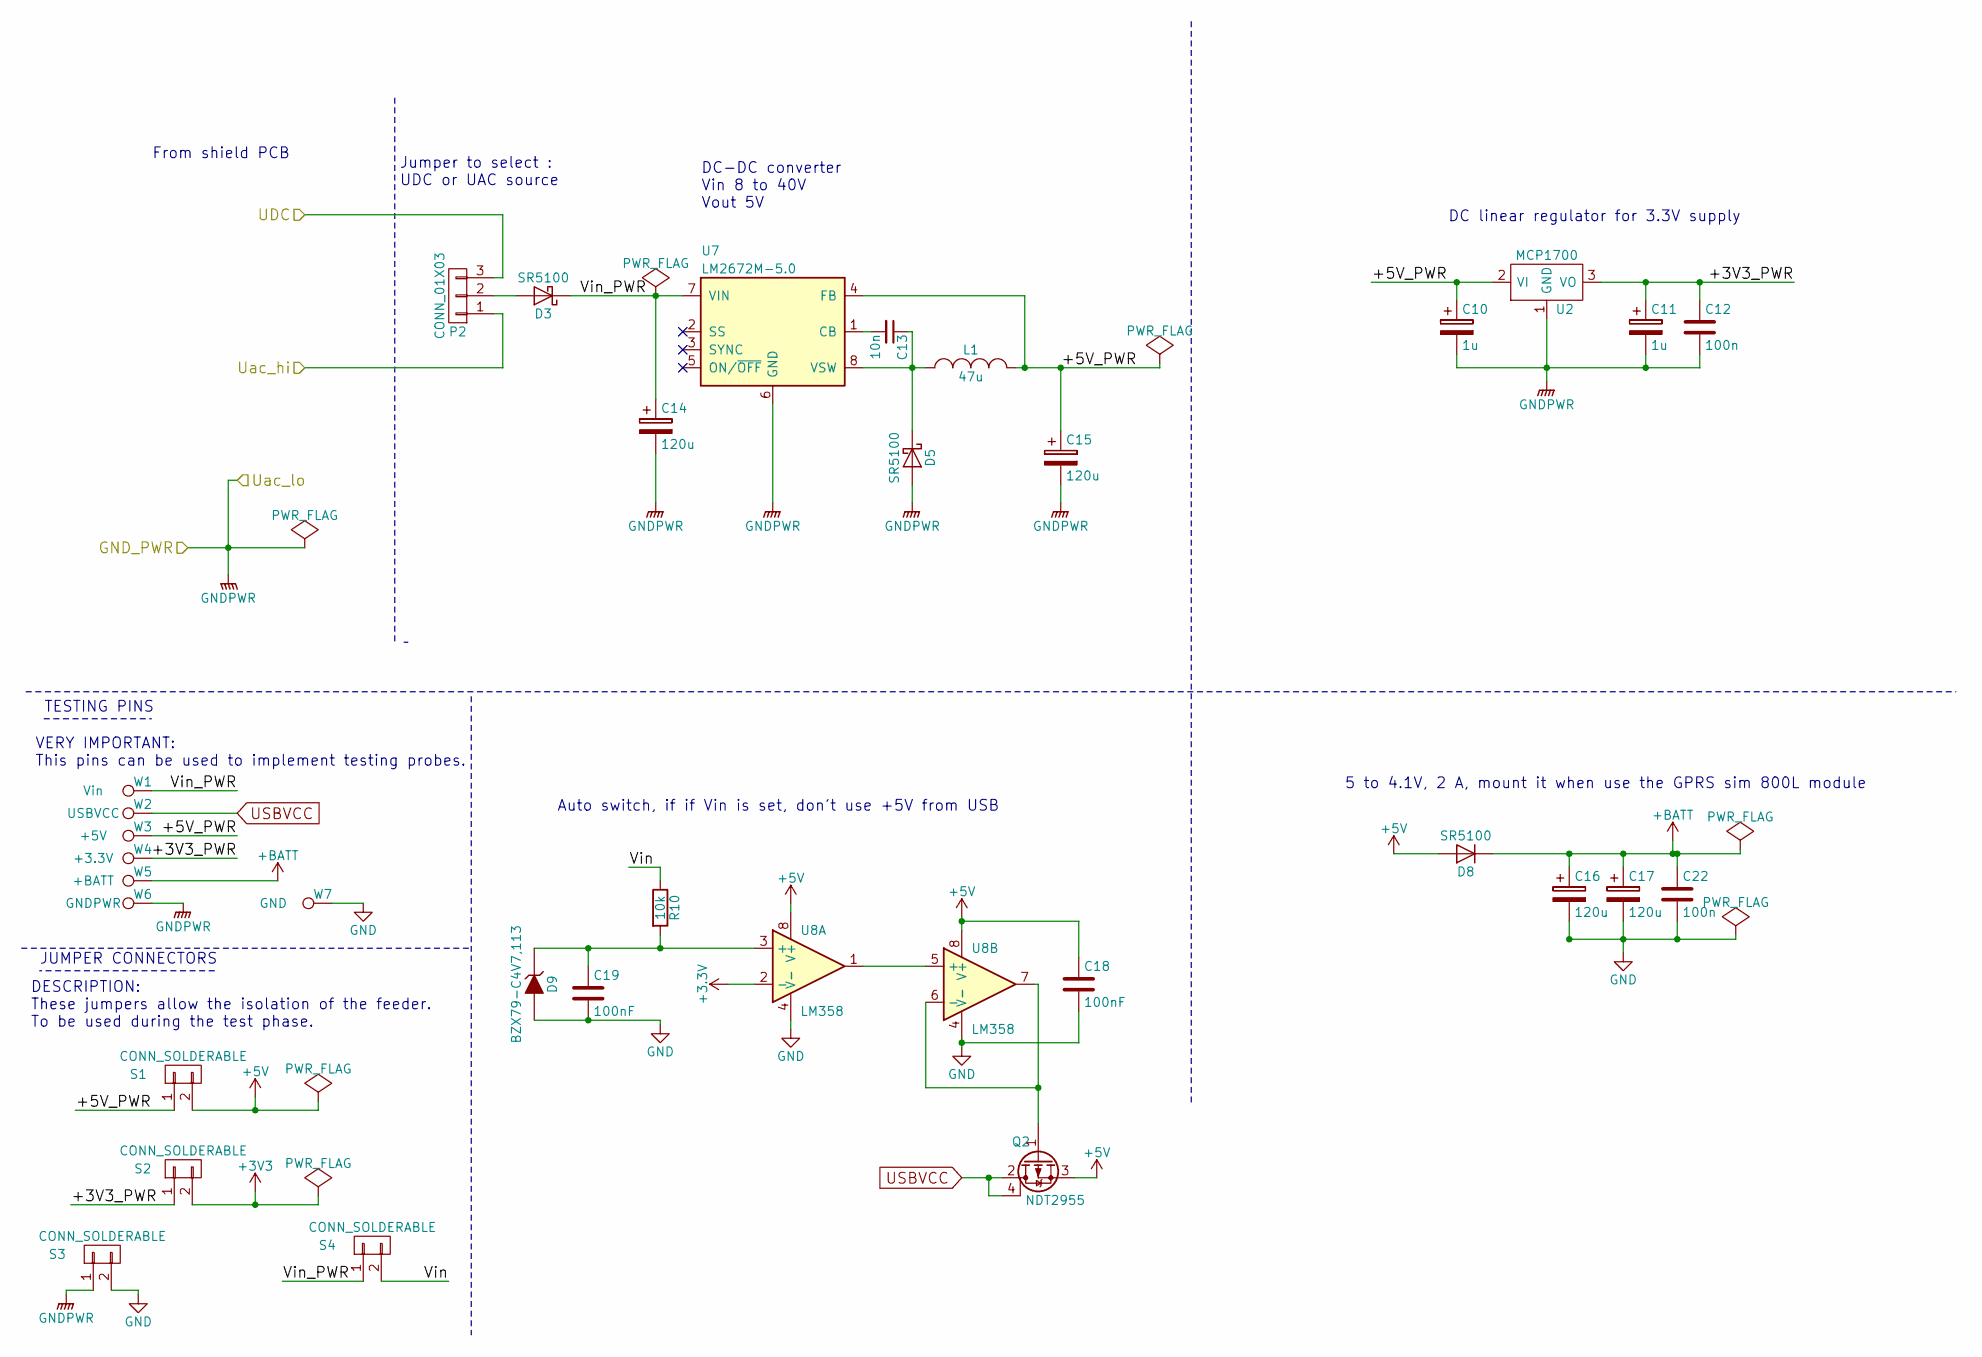
[picture p32: schematic power_supply.sch]

Parts:
C10, C11: 1u; C_Radial_D5_L6_P2.5
C12, C22: 100n; C_Rect_L7_W2.5_P5
C13: 10n; C_Rect_L7_W2.5_P5
C14, C15, C16, C17: 120u; condensator_horizontal_8_11_5
C18, C19: 100nF; C_Rect_L7_W2.5_P5
D3, D5, D8: SR5100; Diode_DO-27_Horizontal_RM12
D9: BZX79-C4V7,113; Diode_DO-35_SOD27_Horizontal_RM10
L1: 47u; inductance_murata_1200LRS
P2: CONN_01X03; Pin_Header_Angled_1x03
Q2: NDT2955; SOT-223
R10: 10k; Resistor_Horizontal_RM10mm
S1, S2, S3, S4: CONN_SOLDERABLE
U2: MCP1700; TO-92_Horizontal1_Inline_Narrow_Oval
U7: LM2672M-5.0; SOIC-8_3.9x4.9mm_Pitch1.27mm
U8: LM358; SOIC-8_3.9x4.9mm_Pitch1.27mm
W1: Vin; Measurement_Point_Square-TH_Big
W2: USBVCC; Measurement_Point_Square-TH_Big
W3: +5V; Measurement_Point_Square-TH_Big
W4: +3.3V; Measurement_Point_Square-TH_Big
W5: +BATT; Measurement_Point_Square-TH_Big
W6: GNDPWR; Measurement_Point_Square-TH_Big
W7: GND; Measurement_Point_Square-TH_Big

Connections:
+3.3V: U8.2 (-)
+3V3: S2.2
+3V3_PWR: C11.1, C12.1, S2.1, U2.3 (VO), W4.1
+5V: C18.1, D8.2 (A), Q2.3 (S), S1.2, U8.8 (V+)
+5V_PWR: C10.1, C15.1, L1.3, S1.1, U2.2 (VI), U7.4 (FB), W3.1
+BATT: C16.1, C17.1, C22.1, D8.1 (K), W5.1
GND: C16.2, C17.2, C18.2, C19.2, C22.2, D9.2 (A), S3.2, U8.4 (V-), W7.1
GNDPWR: C10.2, C11.2, C12.2, C14.2, C15.2, D5.2 (A), S3.1, U2.1 (GND), U7.6 (GND), W6.1
unnamed: C13.1, D5.1 (K), L1.1, U7.8 (VSW)
unnamed: C13.2, U7.1 (CB)
unnamed: C19.1, D9.1 (K), R10.2, U8.3 (+)
unnamed: D3.2 (A), P2.2
unnamed: Q2.1 (G), U8.6 (-), U8.7
unnamed: U8.1, U8.5 (+)
UDC: P2.3
USBVCC: Q2.2 (D), Q2.4 (D), W2.1
Uac_hi: P2.1
Vin: R10.1, S4.2
Vin_PWR: C14.1, D3.1 (K), S4.1, U7.7 (VIN), W1.1

Notes on the sheet:
DC-DC converter Vin 8 to 40V Vout 5V
5 to 4.1V, 2 A, mount it when use the GPRS sim 800L module
From shield PCB
Jumper to select : UDC or UAC source
DC linear regulator for 3.3V supply
Auto switch, if if Vin is set, don't use +5V from USB
DESCRIPTION: These jumpers allow the isolation of the feeder. To be used during the test phase.
JUMPER CONNECTORS
TESTING PINS
VERY IMPORTANT: This pins can be used to implement testing probes.
