netbomo/datalogger-project/Hardware/shield_v210/kicad/F2_windvane.sch

## KiCad design Hardware/shield_v210/kicad/F2_windvane.sch (2017-07-10)

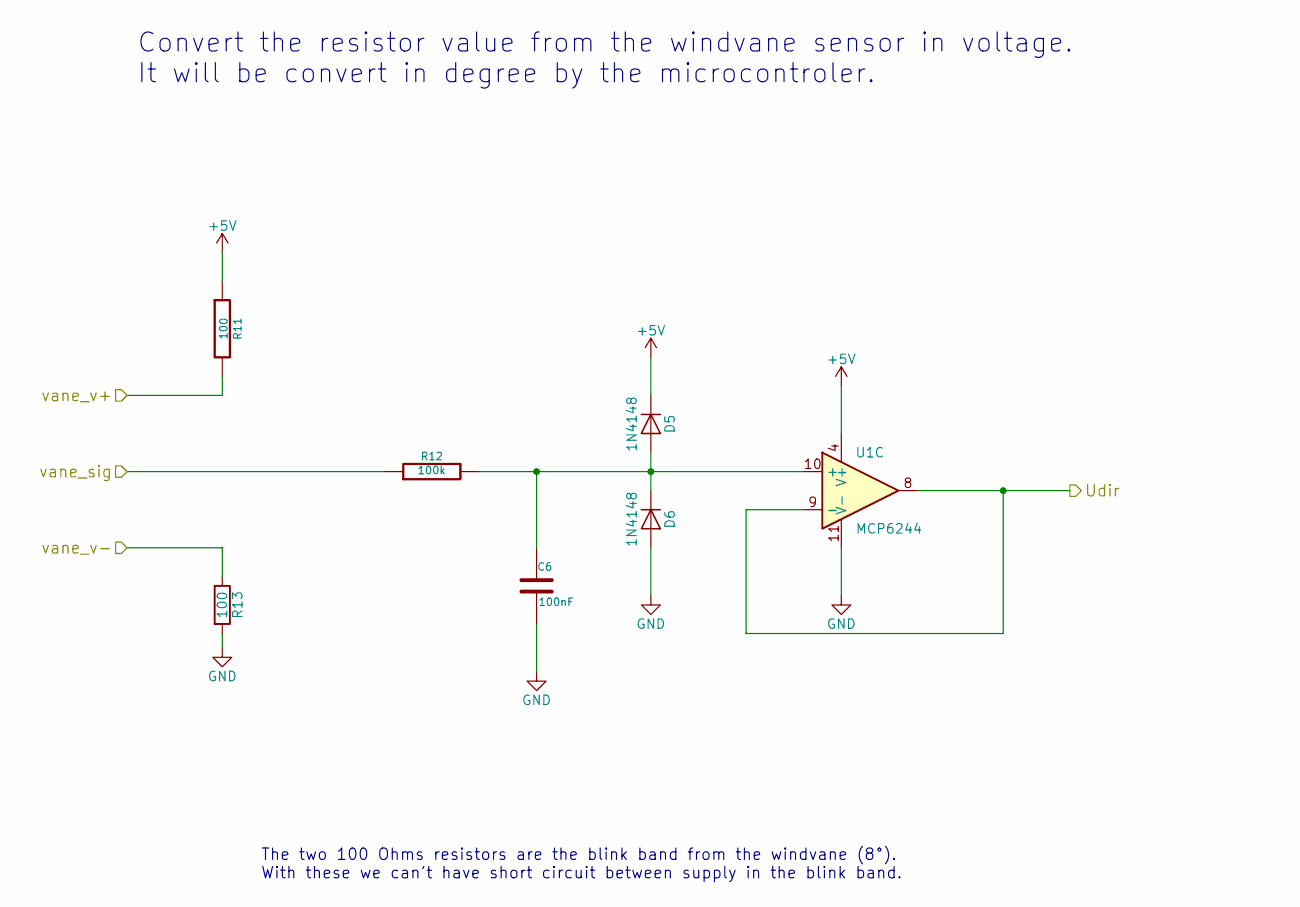
[picture p34: schematic F2_windvane.sch]

Parts:
C6: 100nF; C_Rect_L7_W2.5_P5
D5, D6: 1N4148; DO-35
R11, R13: 100; R4-LARGE_PADS
R12: 100k; R4-LARGE_PADS
U1: MCP6244; DIP-14_W7.62mm_LongPads

Connections:
+5V: D5.1 (K), R11.1, U1.4 (V+)
GND: C6.2, D6.2 (A), R13.2, U1.11 (V-)
unnamed: C6.1, D5.2 (A), D6.1 (K), R12.2, U1.10 (+)
Udir: U1.8, U1.9 (-)
vane_sig: R12.1
vane_v+: R11.2
vane_v-: R13.1

Notes on the sheet:
Convert the resistor value from the windvane sensor in voltage. It will be convert in degree by the microcontroler.
The two 100 Ohms resistors are the blink band from the windvane (8°). With these we can't have short circuit between supply in the blink band.
