netbomo/datalogger-project/Hardware/shield_v210/kicad/F5_temperature.sch

## KiCad design Hardware/shield_v210/kicad/F5_temperature.sch (2017-06-26)

Schematic: F5_temperature.sch

Parts:
C601: 100nF; C_Radial_D5_L6_P2.5
NTC601: 2.2k; R4
R601, R602, R603, R604, R605, R606: 10k; R4
U502, U601: LMV358; DIP-8_W7.62mm_LongPads

Notes on the sheet:
NTCLE100E3222JB0
Convert the ntc resitor in voltage
I will change it by a pt1000 resistor or a ds1820 one wire sensor.
