netbomo/datalogger-project/Hardware/shield_v210/kicad/shield.sch

## KiCad design Hardware/shield_v210/kicad/shield.sch (2017-07-10)

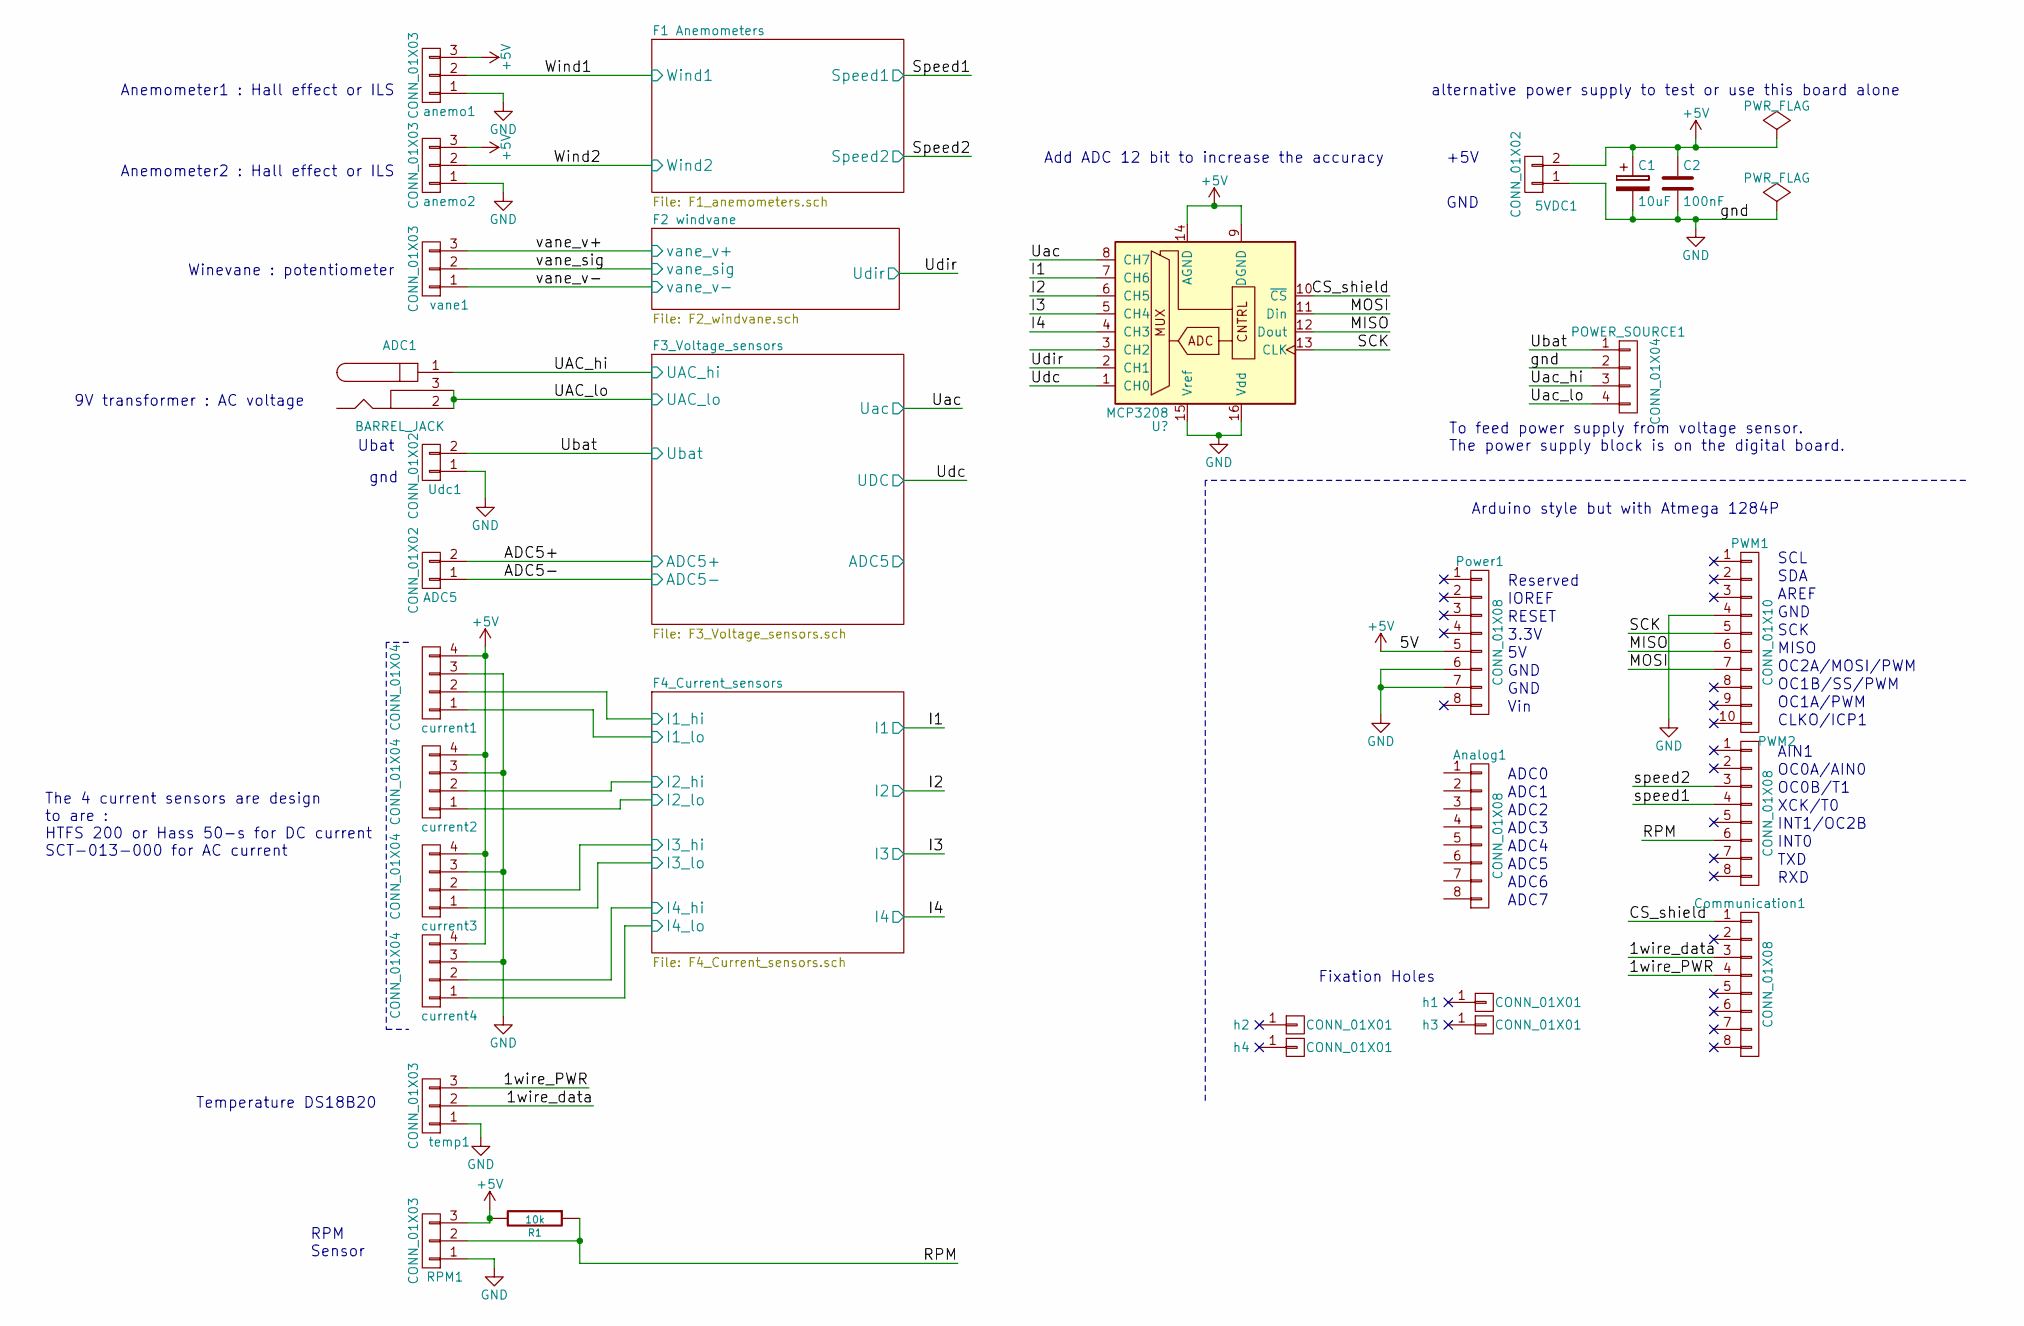
[picture p37: schematic shield.sch]

Parts:
5VDC1: CONN_01X02; Socket_Strip_Straight_1x02
ADC1: BARREL_JACK
ADC5: CONN_01X02; mstba_2,5%2f2-g-5,08
Analog1: CONN_01X08; Socket_Strip_Arduino_1x08
C1: 10uF; C_Radial_D5_L6_P2.5
C2: 100nF; C_Rect_L7_W2.5_P5
Communication1: CONN_01X08; Socket_Strip_Arduino_1x08
POWER_SOURCE1: CONN_01X04; Socket_Strip_Straight_1x04
PWM1: CONN_01X10; Socket_Strip_Arduino_1x10
PWM2: CONN_01X08; Socket_Strip_Arduino_1x08
Power1: CONN_01X08; Socket_Strip_Arduino_1x08
R1: 10k; R4-LARGE_PADS
RPM1: CONN_01X03; mstba_2,5%2f3-g-5,08
Udc1: CONN_01X02; mstba_2,5%2f2-g-5,08
anemo1, anemo2: CONN_01X03; mstba_2,5%2f3-g-5,08
current1, current2, current3, current4: CONN_01X04; mstba_2,5%2f4-g-5,08
h1, h2, h3, h4: CONN_01X01; Arduino_1pin
temp1: CONN_01X03; mstba_2,5%2f3-g-5,08
vane1: CONN_01X03; mstba_2,5%2f3-g-5,08

Connections:
1wire_PWR: Communication1.4, temp1.3
1wire_data: Communication1.3, temp1.2
+5V: 5VDC1.2, C1.1, C2.1, Power1.5, R1.2, RPM1.3, anemo1.3, anemo2.3, current1.4, current2.4, current3.4, current4.4
ADC5+: ADC5.2
ADC5-: ADC5.1
CS_shield: Communication1.1
I1_hi: current1.2
I1_lo: current1.1
I2_hi: current2.2
I2_lo: current2.1
I3_hi: current3.2
I3_lo: current3.1
I4_hi: current4.2
I4_lo: current4.1
MISO: PWM1.6
MOSI: PWM1.7
RPM: PWM2.6, R1.1, RPM1.2
SCK: PWM1.5
Uac_hi: ADC1.1, POWER_SOURCE1.3
Uac_lo: ADC1.2, ADC1.3, POWER_SOURCE1.4
Ubat: POWER_SOURCE1.1, Udc1.2
Wind1: anemo1.2
Wind2: anemo2.2
gnd: 5VDC1.1, C1.2, C2.2, POWER_SOURCE1.2, PWM1.4, Power1.6, Power1.7, RPM1.1, Udc1.1, anemo1.1, anemo2.1, current1.3, current2.3, current3.3, current4.3, temp1.1
speed1: PWM2.4
speed2: PWM2.3
vane_sig: vane1.2
vane_v+: vane1.3
vane_v-: vane1.1

Notes on the sheet:
Anemometer1 : Hall effect or ILS
Winevane : potentiometer
9V transformer : AC voltage
CLKO/ICP1
OC1A/PWM
OC1B/SS/PWM
OC2A/MOSI/PWM
MISO
SCK
GND
AREF
ADC0
ADC1
ADC2
ADC3
ADC4
ADC5
RXD
TXD
INT0
INT1/OC2B
XCK/T0
OC0B/T1
OC0A/AIN0
3.3V
RESET
AIN1
SDA
SCL
RPM Sensor
IOREF
Vin
Reserved
Arduino style but with Atmega 1284P
Temperature DS18B20
Anemometer2 : Hall effect or ILS
+5V
The 4 current sensors are design to are : HTFS 200 or Hass 50-s for DC current SCT-013-000 for AC current
Ubat
To feed power supply from voltage sensor. The power supply block is on the digital board.
gnd
alternative power supply to test or use this board alone
Fixation Holes
ADC6
ADC7
Add ADC 12 bit to increase the accuracy
