netbomo/datalogger-project/Firmware/windlogger_cpp/src/main.cpp

/**
 *******************************************************************************
 *******************************************************************************
 *
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
 *
 *******************************************************************************
 *******************************************************************************
 *
 *
 *    @file   main.cpp
 *    @author gilou
 *    @date   20 avr. 2017
 *    @brief  This is the main file, is the firmware's body.
 *
 *    The firmware works as :
 *    @image html diag_firmware.svg
 */

// gets rid of annoying "deprecated conversion from string constant blah blah" warning
#pragma GCC diagnostic ignored "-Wwrite-strings"

#include <avr/io.h>
#include <util/delay.h>
#include <stddef.h>
#include <stdlib.h>

#include "../lib/main.h"
#include "../lib/FSM.h"
#include "../lib/State.h"
#include "../lib/Usart.h"


int main(){
/******************************************************************************
 * Hardware initialization
 */
	DDRA = 0x00;		// PortA as analog inputs

	DDRB = 0xF7;		// PortB[0-2] are input, other is set to outputs, SPI will be initialise when it will be used.
	PORTB = 0x00;				//	set all portb 's bits to low

	DDRD= 0xFF;			// Config the port D as outputs. D0 to D3 are Usart0 and 1, they will be rewrited.
	PORTD = 0x00;		// Don"t start the Wifi module at the wake up. (D4-7)

	FSM fsm; 					//	FSM instance, that is the state machine mechanism

/******************************************************************************
 * @todo If verbose mode is select ($01=1), display some infos on the uart0
 */
	//fsm.uart0.print("Initialization\r\n");		// print on uart0 "initialisation"

/******************************************************************************
 * Initialize main scope variable
 */
    unsigned char second_old = 0;	// this variable is check if a new second come for the timing management
    second_old = fsm.rtc.get_second();

/******************************************************************************
 * If all initialization are ok, start the program
 */
  	while(1){		//infinity loop, the program will never crash!

	/******************************************************************************
	 * Hardware management
	 */
  		// check if a new char come from the USART0
		if(fsm.uart0.flag_rx0) {
			fsm.character_processing();		// if it's true, process it
			fsm.uart0.flag_rx0 = 0;			// and reset the flag
		}



		// If a new second comes
		FSM::rtc.get_date();
//		mettre à jour le timestamp
		if(second_old!=fsm.rtc.get_second()){
			fsm.measurement_timing_control ();	// check if time comes to do a new measure or not
			second_old = fsm.rtc.get_second();		// update timestamp_old
		}

	/******************************************************************************
	 * This method define the next state from hardware and software flags
	 */
		fsm.new_State_definition();

	/******************************************************************************
	 * This method execute the next state
	 */
		fsm.execute();

	} // loop in the while

	return 0;
}
