netbomo/datalogger-project/Firmware/windlogger_cpp/src/FSM.cpp

/**
 *******************************************************************************
 *******************************************************************************
 *
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
 * 
 *******************************************************************************
 *******************************************************************************
 *
 *
 *    @file   FSM.cpp
 *    @author gilou
 *    @date   20 avr. 2017
 *    @brief  Brief description of file.
 *
 *    Detailed description of file.
 */

// gets rid of annoying "deprecated conversion from string constant blah blah" warning
#pragma GCC diagnostic ignored "-Wwrite-strings"

#include <avr/io.h>
#include <avr/interrupt.h>
#include <stdlib.h>

#include "../lib/main.h"
#include "../lib/FSM.h"
#include "../lib/Sensor.h"
#include "../lib/State.h"
#include "../lib/Usart.h"

/******************************************************************************
 * static software flags definition need to be out of constructor or function.
 */
bool FSM::flag_new_measure = 0;			// set when time come for a new measure
bool FSM::flag_data_averages_ready = 0;	// set when each averages are calculated and ready for the OUTPUT state
bool FSM::flag_config_request = 0;		// set when a string from usart0 finish by "\r\n"
bool FSM::flag_data_frequencies_ready = 0;

/******************************************************************************
 * static global variable definition need to be out of constructor or function.
 */
unsigned long int FSM::timestamp = 0;		// timestamp is an uint32 to stock the current unix time stamp

ringBufS FSM::rBuf;							// uart0 ring buffer
ringBufS *FSM::pRBuf = new(ringBufS);		// usart ring buffer pointer initialization

/******************************************************************************
 * static class definition need to be out of constructor or function. That refer to hardware peripherals
 */
Usart FSM::uart0(0,Usart::BR_115200);	// This is the uart0 definition
Usart FSM::uart1(1,Usart::BR_115200);	// This is the uart0 definition
TWI FSM::twi;							// this is the twi definition
RTC FSM::rtc;								// this is the rtc definition

Logger FSM::logger;						// This is the structure of data stored in the eeprom

Anemometer FSM::anemo1(0);				// Anemometer 1 definition
Anemometer FSM::anemo2(1);				// Anemometer 1 definition
Windvane FSM::windvane(2);				// Windvane sensor definition
Power FSM::pAC(0,1);				// voltage pin, current pin, id
Power FSM::pDC(1,0);				// voltage pin, current pin, id

//Class constructor
FSM::FSM():second_counter(0),nextState(&idle){

	sei();								// enable interrupt

	config.load_logger();				// call the eeprom configuration from the config state

	// initialize each sensors from the sensors_param structure, Be careful! for each new sensor, increase the eeprom.sensor_counter
	anemo1.load_param();
	anemo2.load_param();
	windvane.load_param();
	pAC.load_param();
	pDC.load_param();

	// initialize the ring buffer
	ringBufS_init(pRBuf);					// initialize the usart0's ring buffer

	// initialize each module and test it
//	wifi.enable();
//	wifi.LDO_enable();
//	wifi.test_init();

}

FSM::~FSM(){

}

/******************************************************************************
 * State machine mechanic methods
 */
// This method define the next state from hardware and software flags
void FSM::new_State_definition(){
	if(flag_config_request) {
		flag_config_request = 0;							// Reset flag
		nextState = &config;								// priority 1 : config request process
	}
	else if(flag_new_measure||flag_data_frequencies_ready) nextState = &measure;		// priority 2 : do measurement stuff

	else if(flag_data_averages_ready) {
		flag_data_averages_ready = 0;					// Reset flag
		nextState = &output;							// priority 3 : output process
	}
	else nextState = &sleep;								// priority 4 : go to sleep

	//FSM::uart0.print("nextState = "); nextState->print();  FSM::uart0.print("\r\n");
}

// This method control if a new measure is needed
void FSM::measurement_timing_control (){
	//corriger avec lecture registre second

	second_counter++;						// Use a second counter to compare with the measure_stamp

	if((second_counter%logger.measure_periode)==0)
	//	if((rtc.get_second()%logger.measure_periode)==0)
	{
		flag_new_measure = 1;				// if it's true, we can do a new measure
		second_counter=0;					// reset the counter
	}
}

// This method execute the next state
void FSM::execute(){
	//nextState->print();
	nextState->execute();
}

/******************************************************************************
 * Methods call from hardware flags
 */
// Call when a string from usart0 finish by "\r\n"
void FSM::character_processing (){
	config.addToRequest(uart0.data_udr0);	// save the char in the config_request string

	uart0.set(uart0.data_udr0);				// do a echo to print on the serial terminal

	if (uart0.data_udr0 == 0x08)			// if char is backspace
	{
		config.backspace();
	}
	else if(uart0.data_udr0=='\r')			// if char is end line
	{
		uart0.print("\r\n");				// print carriage return and new line on the serial termial

		config.endString();

		flag_config_request=1;				// set flag to go in conf mode to do config update
	}

	uart0.flag_rx0 = 0;						// reset the flag
}

/**
 * \brief the timer2 is use with an external 32.768 Hz crystal to provide a RTC
 *
 * At each timer2 overflow, the static uint32 timestamp is incremented
 */
ISR(TIMER2_OVF_vect){
	FSM::timestamp++;
}
