netbomo/datalogger-project/Firmware/windlogger_cpp/src/st_Measure.cpp

/**
 *******************************************************************************
 *******************************************************************************
 *
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
 * 
 *******************************************************************************
 *******************************************************************************
 *
 *
 *    @file   Measure.cpp
 *    @author gilou
 *    @date   20 avr. 2017
 *    @brief The class Measure inherits from the class State.
 *
 *    This class organize measurement process and call sub functions to get data from inputs and average there.
 */

// gets rid of annoying "deprecated conversion from string constant blah blah" warning
#pragma GCC diagnostic ignored "-Wwrite-strings"

#include <avr/io.h>
#include <string.h>
#include <stdlib.h>

#include "../lib/main.h"
#include "../lib/FSM.h"
#include "../lib/st_Measure.h"


/******************************************************************************
 * Constructor and destructor
 */
Measure::Measure(){
	strcpy(m_name,"measure\0");
} // Constructor

Measure::~Measure(){} // Destructor


/******************************************************************************
 * inherits from State
 */
void Measure::execute (){
	PORTB |= _BV(LED_PIN);						// Turn on the green led (blink each time the measure.execute() come)

	if(FSM::flag_new_measure){
		//FSM::uart0.print("flag_new_measure\r\n");
		if(FSM::logger.measure_counter==0){		// if it's a new data flow
			//FSM::uart0.print("reset measure_counter\r\n");
			clear_data_array();					// clear the data array
		}
		freq_init_measurement();				// init frequencies measurement
		windvane_value();						// read the value from the windvane, convert it in 0-359° value
		power_read_value();						// do power measurement todo à préciser!
		temperature_read_value();				// read temperature from the DS18B20
		FSM::logger.measure_counter++;			// increase the measureCounter

		FSM::flag_new_measure = 0;				// reset the flag
	}

	if(FSM::flag_data_frequencies_ready){
		//FSM::uart0.print("flag_data_frequencies_ready\r\n");
		freq_read_value();								//	read data from anemometer and RPM
		FSM::flag_data_frequencies_ready = 0;			//	reset the flag
	}

	if(FSM::logger.measure_counter==FSM::logger.measure_max){
		calc_average();									// if measurement sequence is finish, average data

		FSM::timestamp = FSM::rtc.get_timestamp();		// Save the timestamp associate

		FSM::flag_data_averages_ready=1;
		//FSM::uart0.print("flag_data_averages_ready\r\n");
	}

	PORTB &= ~_BV(LED_PIN);						// turn off the green led
}

void Measure::print(){
	FSM::uart0.print(m_name);		// Print name
}

bool Measure::isEqual(char *name)const {
	return State::isEqual(name);
}




//this method clear data value to save news
void Measure::clear_data_array (){

}

//this method initialize frequency measurement for anemometer and RPM
void Measure::freq_init_measurement (){
	FSM::anemo1.start();
	FSM::anemo2.start();
}

//read the windvane value en map it between 0 to 359 degres
void Measure::windvane_value (){
	FSM::windvane.read_value(FSM::logger.measure_counter);
}

// read power value - not define realy (see emonLib)
void Measure::power_read_value (){
	FSM::pAC.read_values(FSM::logger.measure_counter,4, 1500); // mesure number, number of crossing, timeout = time_you_want/((1/f_clock)*1024) = 96ms/((1/16MHz=*1024) = 1500

	FSM::pDC.read_values(FSM::logger.measure_counter,4,500);		// mesure number, number of crossing, timeout = time_you_want/((1/f_clock)*1024) = 32ms/((1/16MHz=*1024) = 500
}

// read the temperature value from one DS18b20 sensor
void Measure::temperature_read_value (){

}

// read value from anemometer and RPM
void Measure::freq_read_value (){
	FSM::anemo1.read_value(FSM::logger.measure_counter);
	FSM::anemo2.read_value(FSM::logger.measure_counter);
}

// calcul average from the data array
void Measure::calc_average (){
	// For each sensor, calc average
	FSM::anemo1.calc_average();
	FSM::anemo2.calc_average();
	FSM::windvane.calc_average();
	FSM::pAC.calc_averages();
	FSM::pDC.calc_averages();

	FSM::logger.measure_counter=0;	// initialize the next measure

}
