netbomo/datalogger-project/Firmware/windlogger_cpp/src/Usart.cpp

/**
 *******************************************************************************
 *******************************************************************************
 *
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
 * 
 *******************************************************************************
 *******************************************************************************
 *
 *
 *    @file   Usart.cpp
 *    @author gilou
 *    @date   26 avr. 2017
 *    @brief  This is the uart library for the atmega1284p
 *
 *    This class permit to define, the uart0 and uart1.
 *    It's possible to send data as char or string. Interruption needs to be set for receive char.
 */

#include <avr/io.h>
#include <avr/interrupt.h>

#include "../lib/main.h"
#include "../lib/Usart.h"
#include "../lib/FSM.h"

/******************************************************************************
 * static software flags definition need to be out of constructor or function.
 */
	char Usart::data_udr0 = 0;			//	This register permit at the usart0 rx interrupt to store the UDR register
	bool Usart::flag_rx0 = 0;			//	Is set by the uart0 rx interrupt
	char Usart::data_udr1 = 0;			//	This register permit at the usart1 rx interrupt to store the UDR register
	bool Usart::flag_rx1 = 0;			//	Is set by the uart1 rx interrupt

Usart::Usart(unsigned char usart, unsigned int baudrate) {
	// TODO add uart1 support

	switch (usart) {
		case 0:
			m_usart = usart;	// save uart number
			UBRR0 = baudrate; 	// set the baudrate

			UCSR0A = _BV(U2X0); // for the baud rate setting

			UCSR0B = _BV(RXCIE0) | _BV(RXEN0) |_BV(TXEN0); //enable receiver and transmitter
			UCSR0C =  _BV(UCSZ01) | _BV(UCSZ00);	// Set frame format : 8data 1stop bit

			break;
		case 1:
			m_usart = usart;	// save uart number
			UBRR1 = baudrate; // set baud rate

			UCSR1A = _BV(U2X0); // for the baud rate setting

			UCSR1B = _BV(RXCIE1) | _BV(RXEN1) |_BV(TXEN1); //enable receiver and transmitter
			UCSR1C =  _BV(UCSZ11) | _BV(UCSZ10);	// Set frame format : 8data 1stop bit
			break;
		default:
			break;
	}

}


/******************************************************************************
 * \fn Interrupt Sub routine(uart0 reception vector)
 * \brief this sub routine comes when a char is received on the uart0
 */
ISR(USART0_RX_vect)
{
	Usart::data_udr0 = UDR0;		// save the char in the data_udr0 register
	Usart::flag_rx0 = 1;			// and set the flag
}

/******************************************************************************
 * \fn Interrupt Sub routine(uart1 reception vector)
 * \brief this sub routine comes when a char is received on the uart1
 */
ISR(USART1_RX_vect)							//sous routine d'interruption lors d'une reception
{
	Usart::data_udr1 = UDR1;						//récupération du registre de donnée UDR0 dans la variable globale data_udr0
	Usart::flag_rx1 = 1;					//mise à 1 du drapeau de reception pour interruption
}

/******************************************************************************
 * sending data methods
 */
// USART char sender function
void Usart::set(char character){
	switch (m_usart) {
	case 0:
		while ( !( UCSR0A & (1<<UDRE0)) );	// Wait for empty transmit buffer
		UDR0 = character;					// Put data into buffer, sends the data
		break;
	case 1:
		/* Wait for empty transmit buffer */
		while ( !( UCSR1A & (1<<UDRE1)) )
			;
		/* Put data into buffer, sends the data */
		UDR1 = character;
		break;
	default:
		break;
	}
}

// USART string sender function
void Usart::print(char* string){
	uint8_t i = 0;

		while(*(string+i)!='\0')	// the char is not equal to '\0,' the end string character
		{
			set(*(string+i));		// send the char
			i++;					// increase the index
		}
}
