netbomo/datalogger-project/(commit log)

2017-04-26 Add usart class and blink led test
2017-06-26 windvane sensor added
2017-06-26 update hardware folder
    [BOM_digital_1_1_1.ods, F1_anemometers.sch, F2_windvane.sch, F3_Voltage_sensors.sch, F4_Current_sensors.sch, F5_temperature.sch, digital.csv, digital.sch]
2017-06-26 folder renamed
    [BOM_digital_1_1_1.ods, digital.csv, digital.sch, digital_bom.csv, microC.sch, output.sch, power_supply.sch]
2017-06-27 anemometer sensors added
2017-06-27 Power sensor added
2017-06-30 update power class
    [F3_Voltage_sensors.sch]
2017-07-05 power dirty modification
2017-07-06 move power to powerDC and powerAC
    [power_supply.sch]
2017-07-07 correct power eeprom's structure and resolve pins call glitch
    [FSM.cpp, Power.cpp, st_Config.cpp, st_Measure.cpp]
2017-07-10 translating from c to cpp
    [BOM_digital_1_1_1.ods, F1_anemometers.sch, F2_windvane.sch, F3_Voltage_sensors.sch, F4_Current_sensors.sch, F5_temperature.sch, digital.csv, digital.sch]
2017-07-11 update powers classes
2017-09-11 esp826612 lib added to windlogger_cpp bug display config menu
    [FSM.cpp, Usart.cpp, esp826612.cpp, main.cpp]
2017-09-12 improve ring buffer to uart0
