netbomo/datalogger-project/(notices)

Notices in the files:
Firmware/windlogger_cpp/src/Power.cpp:
License :
This program is free software: you can redistribute it and/or modify
it under the terms of the GNU General Public License as published by
the Free Software Foundation, either version 3 of the License, or
any later version.
Hardware/digital_v120/kicad/output.sch:
AGPL3
